dudasdavid/co2-monitor-gen2/documents/spi/ESP32S3-128SPIx系列开发板开发参考  V1.0.pdf

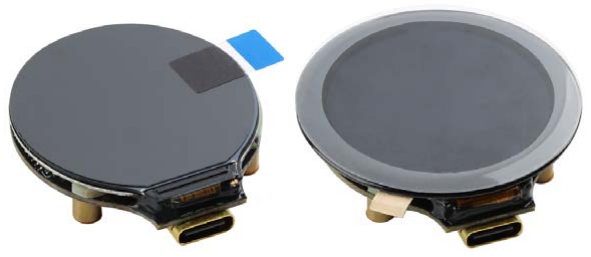
[picture p34: figure]

1 / 24

## 1.28 寸 ESP32S3 圆形 TFT-SPI 屏幕开发板

开发参考文档

时间 2025/04/19

版本 V1.0

2 / 24

修订历史

日期 | 版本 | 发布说明
2025-04-19 | V1.0 | ● 首次发布

3 / 24

一、 文档说明

开发板主体以 ESP32-S3 为核心，并搭配丰富的外设以及供电等电

路设计，开发板通过长按中间按键 3S 实现开关机，本文档展开对开

发板各个板块的功能进行分析以便用户进行开发。

文档按照下面几大方面对开发板进行拆解分析，注意代码部分需

要配合资料工程 FullFunctionTest 阅读，共同学习进步。

ESP32-S3 核心参数

UPS 供电切换稳压 & 开关机

锂电池充电 & 电量检测

屏幕参数显示 & 电容触摸

物理按键

QMI8658 陀螺仪

PCF85063 RTC 时钟

TF 卡

IIS 音频输出 & MIC

WS2812 & 扩展 IO

二、 ESP32-S3 核心参数

ESP32-S3 核心部分有 ESP32-S3 芯片，外挂的 FLASH & PSRAM,以

及下载模式控制按键与天线几大部分组成。

ESP32-S3 芯片运行频率及基本功能等参数不再赘述，可参考官方

芯片手册。

本次开发板，外挂有 16MB 的 FLASH,采用四线 SPI 进行连接。

4 / 24

PSRAM 部分为 ESP32-S3 芯片内置，出货有 8MB 和 16MB 两种版本

供用户选择，PSRAM 内部为 OPI 连接方式，使用时务必选择 OPI PSRAM，

否则将会无法识别。

开发板仅有的 USB 口连接至芯片的 IO19 D- 和 IO20 D+ 两个引

脚用于下载调试，因此在下载时请选择 USB 下载，而非 UART 下载，

而对于想要使用 USB 口进行串口打印的用户，打开 USB CDC On Boot

的功能可以使用 Serial.print 等语法打印调试信息。

对于部分用户会出现烧录时代码选项设置为关闭 USB，这在下载

之后将无法再找到 USB 口，电脑也无法再识别到 USB 口，以及关闭

USB 下载功能后识别到 USB 口但无法下载的情况，这种情况需要使用

板载的两颗微型物理按键进入下载模式，如下图

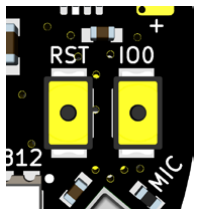
[picture p35: figure]

按住 IO0 按键不松，再次按下 RST 按键随后松开 RST 按键，再随后松

开 IO0 按键，ESP32-S3 将进入下载模式，值得注意的是此处的 IO0 按

键不建议作为常规物理按键去实现功能，因为 IO0 已经作为触摸复位

使用。

天线默认采用板载的天线，预留的 IPEX 需要更改电阻切换，外接

IPEX 天线需要将下方 0Ω电阻更换到另一侧的位置进行焊接。


5 / 24

→


三、 供电 & 开关机

供电部分提供了外部 VIN 输入焊盘，USB，以及 BAT 电池三种供电

方式。


其中 VIN 焊盘与 USB 的电源端直接连通，请注意使用，电压请勿

超过 5.5V，并且均可为电池进行充电。

USB 供电与电池供电使用两颗理想二极管实现 UPS 切换功能，电

流随后经过电源控制开关供电至 TPS63802 升降压芯片，稳压 3.3V 输

出给 ESP32-S3 以及其他板块使用。

电源控制开关由中间按键进行控制，长按 3 秒以上开机或关机，

因此平时可以作为普通按键进行使用。


关机后仅开关控制部分以及电池充电部分的电流消耗，实测关机后静

态电流约 7ua。

如果需要上电就开机而不是通过按键控制，那么可以短接下方图


6 / 24

示的两个焊点，短接后上电即开机。

四、 锂电池充电 & 电量检测

电池可以选择 3.7V 可充电锂电池，充电部分使用 BQ25170 芯片进

行充电。

BQ25170 支持以下电池

- 锂离子电池：4.05V、4.1V、4.2V、4.35V、4.4V
- 磷酸铁锂电池：3.5V、3.6V、3.7V

默认设置充电电压为 4.2V，适配标定 3.7V 的锂电池进行使用

依据芯片手册，通过修改下方位置电阻调节


对应关系如下

最大电流 800ma 可调节，电流默认设置为最大 600ma

7 / 24


对应关系如下 ICHG = KISET/RISET

其中 ICHG为需要设置的充电电流 KISET为增益因子，其值为 270-330 典

型值 300，由此可计算出对应充电电流需要使用的电阻 RISET，默认 499

Ω。

充电指示灯在无电池接入时，接入 USB 口或 VIN 供电指示灯会处

于闪烁的状态，接入电池后在充电状态下会常亮，充满后熄灭，充电

芯片并非低于 4.2V 就开始充电，而是有一个阈值，低于才开始充电，

属于正常现象，具体可参考资料中芯片手册。

值得注意的是 TPS63802 升降压芯片，可以在低至 2V 以下的电压

下工作，并且由于没有板载电池过放电路，因为电池选型是最好使用

带保护板型号的电池。

电量检测的方式以检测电池电压为主，电池电压通过两个 100K 电

阻分压后连接到 ESP32-S3 的 IO1 端口，参考下图即可


电池未接入时电压会处于浮动状态，上图为参考电路，不会增加开发

板静态功耗，静态功耗仍然会在 7ua 左右。

五、 屏幕 & 电容触摸

屏幕为圆形显示区域，1.28in 分辨率 240x240 的 IPS 彩色显示

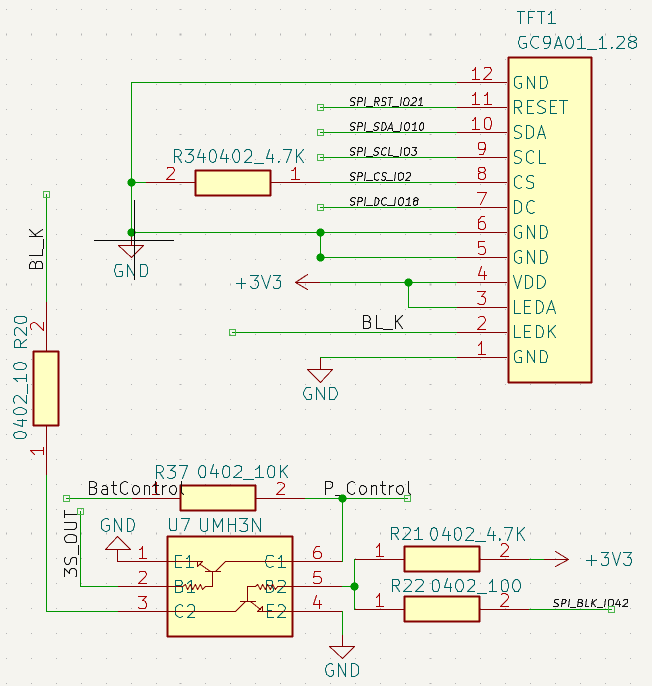
[picture p36: figure]

8 / 24

屏，其驱动为 GC9A01,硬件驱动接口为 SPI 接口，部分文档叫串行接

口，和 ESP32-S3 的连接可参照下图部分

SDA | 数据引脚 | IO10
RST | 复位引脚 | IO21
SCL | 时钟引脚 | IO3
DC | 数据/命令 | IO18
CS | 片选 | IO2
BLK | 背光控制 | IO42

提供的测试代码使用 Arduino_GFX_Library (https://github.com/moononournation/Arduino_GFX) 的库进行驱动，由于

该库存在多个版本，并且不完全兼容，建议使用资料中已经打包好的

1.4.7 版本库，解压后添加到 Arduino IDE 存放库的路径下即可，不

做过多赘述

示例代码中

1 | #include <Arduino_GFX_Library.h> //添加库文件引用

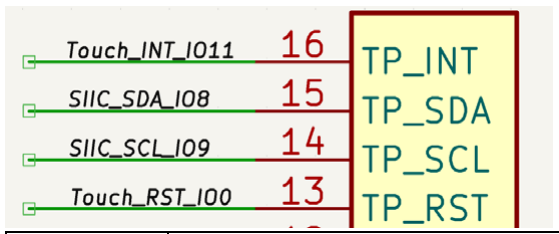
[picture p37: figure]

9 / 24

通过下方代码进行初始化

1

2

3

4

5

#define GFX_BL 42

#define BL_Freq 5000

unsigned int BL_Brightness = 255;

Arduino_DataBus *bus = new Arduino_ESP32SPI(18 /* DC */, 2 /* CS */, 3 /* SCK */, 10 /* MOSI */, -1 /* MISO */, HSPI /* spi_num */);

Arduino_GFX *gfx = new Arduino_GC9A01(bus, 21 /* RST */, 0 /* rotation */, true /* IPS */);

1

2

gfx ->begin(); //Initialize LCD

gfx->fillScreen(BLACK); //Background color Black
随后即可调用 ARDUINO GFX 库中所提供的函数进行显示驱动

可参照 gfx->fillScreen(BLACK); 设置背景色为黑色等功能，具体可查看库作者的

github：https://github.com/moononournation/Arduino_GFX

电容触摸使用 CST816 触摸专用芯片(仅触摸版本查看),采用 IIC

驱动，带复位及中断引脚，IIC 器件地址 0x15，与 ESP32-S3 的硬件

连接如下图所示

SDA | 数据引脚 | IO8
SCL | 时钟引脚 | IO9
RST | 复位引脚,低电平有效 | IO0
INT | 中断引脚 | IO11

值得注意 RST 与 INT 引脚，RST 引脚使用 IO0，因此前文 IO0 按键在

触摸版本中无法当普通按键使用，否则会影响到触摸功能。

示例代码中下方位置定义了 IIC 使用的引脚

10 / 24

1 | //IIC
2 | #define SCL 9
3 | #define SDA 8
以下代码定义了复位引脚，IIC 器件地址 0x15 以及 ID 寄存器地址与

寄存器中值的含义

01 | //CST816
02 | #define TouchRST 0
03 | #define TouchInt 11
04 | #define TouchI2CAddr 0x15

05

06 | #define ChipIdRegister 0xA7
07 | #define CST716ChipId 0X20
08 | #define CST816SChipId 0XB4
09 | #define CST816TChipId 0XB5
10 | #define CST816DChipId 0XB6
11 | #define CST826ChipId 0X11
12 | #define CST830ChipId 0X12

#define CST836UChipId 0X13

以下代码复位触摸芯片并检测芯片 ID 判断触摸芯片具体型号
01 | pinMode(TouchRST, OUTPUT);
02 | pinMode(TouchInt,INPUT_PULLUP);
03 | attachInterrupt(digitalPinToInterrupt(TouchInt), TouchHandleInterrupt, FALLING);
04 | digitalWrite(TouchRST, LOW); delay(10);
05 | digitalWrite(TouchRST, HIGH); delay(50);

06

07 | Wire.beginTransmission(TouchI2CAddr);
08 | Wire.write(ChipIdRegister);
09 | Wire.endTransmission(false);
10 | Wire.requestFrom(TouchI2CAddr, 1 ,true);
11 | ChipID = Wire.read();
1 | Serial.printf("\r\nTouchChipID: 0x%02X",ChipID);
2 | if(ChipID == CST716ChipId) Serial.println(",Touch chip model :CST716");
3 | else if(ChipID == CST816SChipId) Serial.println(",Touch chip model :CST816S");
4 | else if(ChipID == CST816TChipId) Serial.println(",Touch chip model :CST816T");
5 | else if(ChipID == CST816DChipId) Serial.println(",Touch chip model :CST816D");
6 | else if(ChipID == CST826ChipId) Serial.println(",Touch chip model :CST826");
7 | else if(ChipID == CST830ChipId) Serial.println(",Touch chip model :CST830");
8 | else if(ChipID == CST836UChipId) Serial.println(",Touch chip model :CST836U");
9 | else Serial.println(",error!");

11 / 24

坐标检测函数

01 | void my_touch_read(lv_indev_drv_t * indev_drv, lv_indev_data_t * data){
02 | //Store the pressed coordinates and status
03 | lv_coord_t last_x = 0;
04 | lv_coord_t last_y = 0;
05 | unsigned int X_H4 = 0;
06 | unsigned int X_L8 = 0;
07 | unsigned int Y_H4 = 0;
08 | unsigned int Y_L8 = 0;
09 | //True if there is touch, false otherwise
10 | if(TouchEventFlag) {
11 | Wire.beginTransmission(TouchI2CAddr);
12 | Wire.write(0x03);
13 | Wire.endTransmission(false);
14 | //Wire.beginTransmission(TouchI2CAddr);
15 | Wire.requestFrom(TouchI2CAddr, 1 ,true);
16 | X_H4 = Wire.read();

17

18 | Wire.beginTransmission(TouchI2CAddr);
19 | Wire.write(0x04);
20 | Wire.endTransmission(false);
21 | //Wire.beginTransmission(TouchI2CAddr);
22 | Wire.requestFrom(TouchI2CAddr, 1 ,true);
23 | X_L8 = Wire.read();

24

25 | Wire.beginTransmission(TouchI2CAddr);
26 | Wire.write(0x05);
27 | Wire.endTransmission(false);
28 | //Wire.beginTransmission(TouchI2CAddr);
29 | Wire.requestFrom(TouchI2CAddr, 1 ,true);
30 | Y_H4 = Wire.read();

31

32 | Wire.beginTransmission(TouchI2CAddr);
33 | Wire.write(0x06);
34 | Wire.endTransmission(false);
35 | //Wire.beginTransmission(TouchI2CAddr);
36 | Wire.requestFrom(TouchI2CAddr, 1 ,true);
37 | Y_L8 = Wire.read();

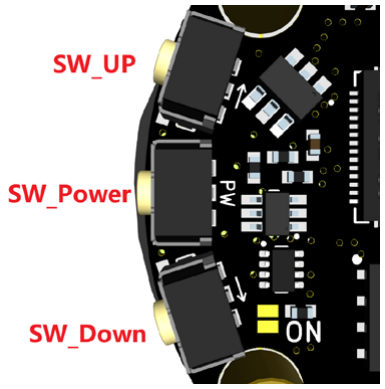
[picture p38: figure]

12 / 24

01 | last_x = 0xFF - (X_H4 << 8 | X_L8)&0X0FFF;
02 | last_y = (Y_H4 << 8 | Y_L8)&0X0FFF;
03 | data->point.x = last_x;
04 | data->point.y = last_y;

05

06 | TouchEventFlag = false;
07 | //Serial.printf("Touch Point:%02X , %02X \r\n",last_x,last_y);
08 | data->state = LV_INDEV_STATE_PR;
09 | }
10 | else {
11 | data->state = LV_INDEV_STATE_REL;
12 | }
13 | }
注意以上代码需要搭配完整代码使用，并非直接复制使用的，仅作

为代码分析学习共同进步的作用

六、 物理按键

开发板板载有 5 个物理按键，其中两个模式控制及复位不作为普

通按键使用，三个侧面按键连接至 TCA6408 的 P3 P4 P5,按键连

接参考与位置如图所示

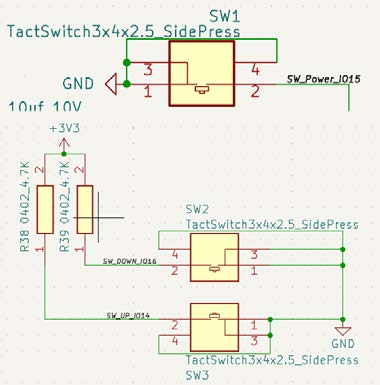
[picture p39: figure]

值得一说的是中间的按键不仅作为普通按键使用还承担了电源开

关的功能，长按 3 秒将会让开发板开机或关机，当然，再次说明可

以短接下方 ON 位置焊盘来取消开关机的功能。

七、 QMI8658 陀螺仪(未焊接)

13 / 24

QMI8658 是一颗六轴惯性测量单元芯片，具有三轴陀螺仪、三轴加

速度计，足够进行姿态以及运动状态检测，通过 IIC 与 ESP32-S3 进

行通信，带两个中断引脚，分别对应陀螺仪的中断与加速度计的中断

供用户使用。

其 IIC 器件地址为 0x6B，开发板上连接可参照下图或表

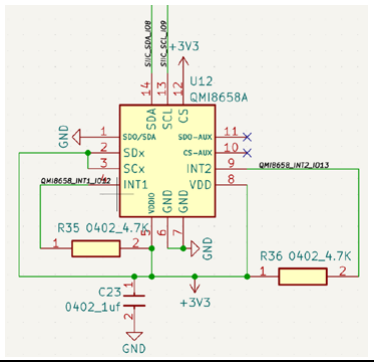
[picture p40: figure]

SCL | 时钟引脚 | IO9
SDA | 数据引脚 | IO8
IMU_INT1 | 中断引脚 1 | IO12
IMU_INT2 | 中断引脚 2 | IO13

驱动代码可参考资料工程 FullFunctionTest 以及芯片手册进行

阅读，足够了解该类型芯片的用户可以自行编码驱动，或者选型移

植示例中的代码，本代码中 IMU 部分同样移植自微雪的示例，节省

大量时间，感谢微雪电子，同时也建议移植已验证代码去使用。

八、 PCF85063 RTC 时钟(未焊接)

PCF85063 这颗 RTC 时钟芯片同样采用 IIC 进行通信，得益于 IIC

总线的特性，他与开发板上其他 IIC 器件一样均共用一组 IIC 引脚，

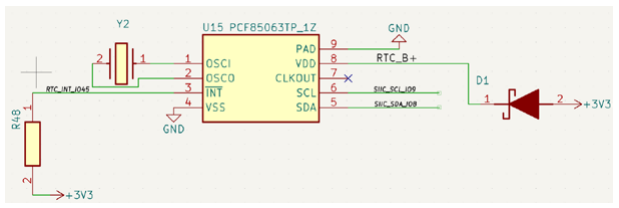
[picture p41: figure]

14 / 24

用于设置或读取时间等参数。

除此之外这颗芯片拥有 INT 引脚，我们将他连接到了 TCA6408 扩

展芯片的 P7 引脚，INT 引脚设置半分钟或者一分钟中断，可以在

ESP32-S3 进入低功耗的状态下通过这个中断的状态进行唤醒，当然

也可以用于其他的有趣的方案。

芯片于开发板其他部件的连接可以参考下图或表

SCL | 时钟引脚 | IO9
SDA | 数据引脚 | IO8
INT | RTC 中断引脚 | IO45

对于电源部分，RTC 的电源显然是非常重要的，板载有 RTC 电池

的连接端口，推荐使用 3V 电压的可充电电池，在 RTC 电池未接入时

芯片通过板载的 3.3V 稳压获取电源，RTC 电池接入后 3.3V 将会给

RTC 电池进行充电，在开发板关机时芯片将由 RTC 电池进行续电工作，

静态电流可以参考芯片手册。

PCF85063 拥有 11 个寄存器，每个寄存器有 8 个位，可以分为两

类，一类为配置参数，另一类为时间参数。

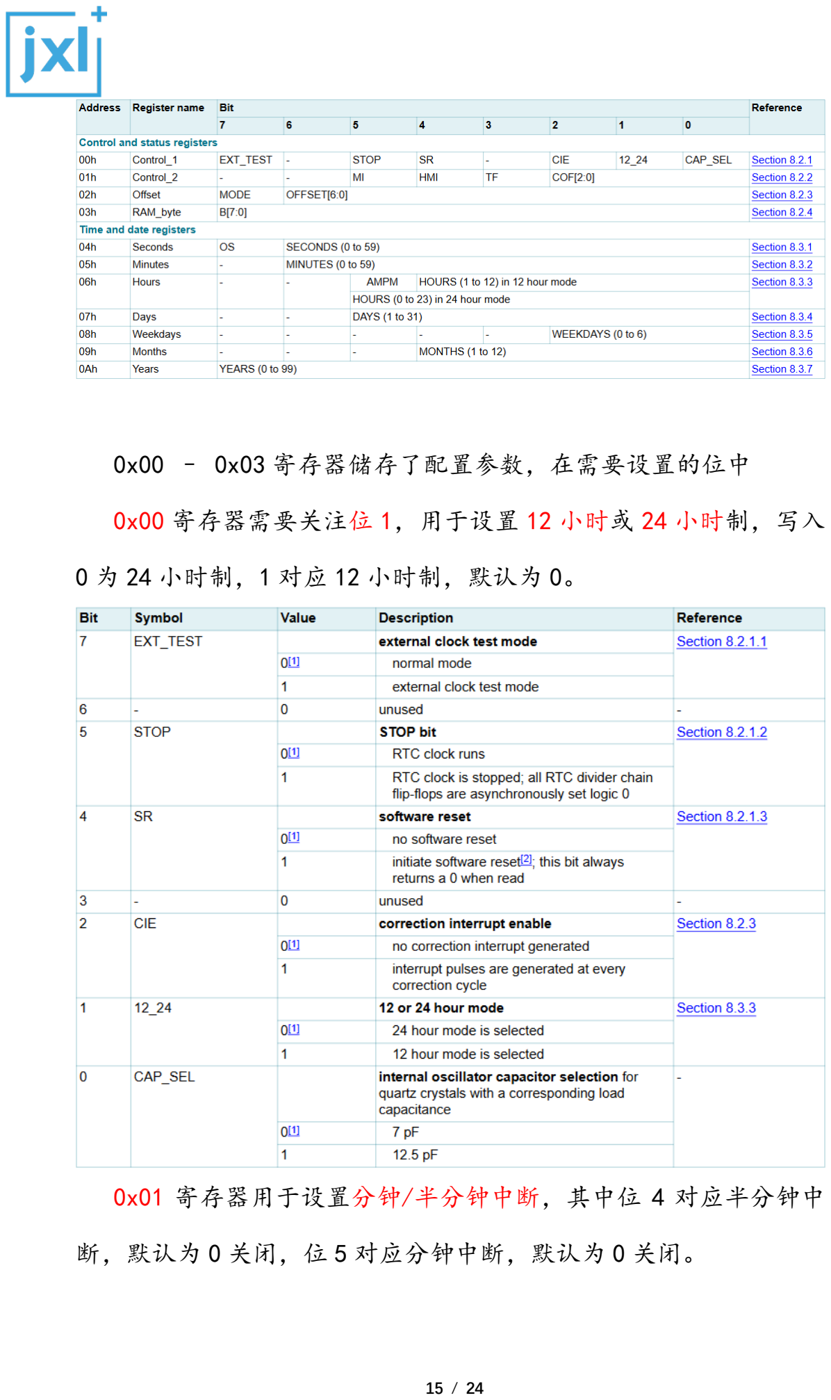
[picture p42: page 15]

15 / 24

0x00 – 0x03 寄存器储存了配置参数，在需要设置的位中

0x00 寄存器需要关注位 1，用于设置 12 小时或 24 小时制，写入

0 为 24 小时制，1 对应 12 小时制，默认为 0。

0x01 寄存器用于设置分钟/半分钟中断，其中位 4 对应半分钟中

断，默认为 0 关闭，位 5 对应分钟中断，默认为 0 关闭。

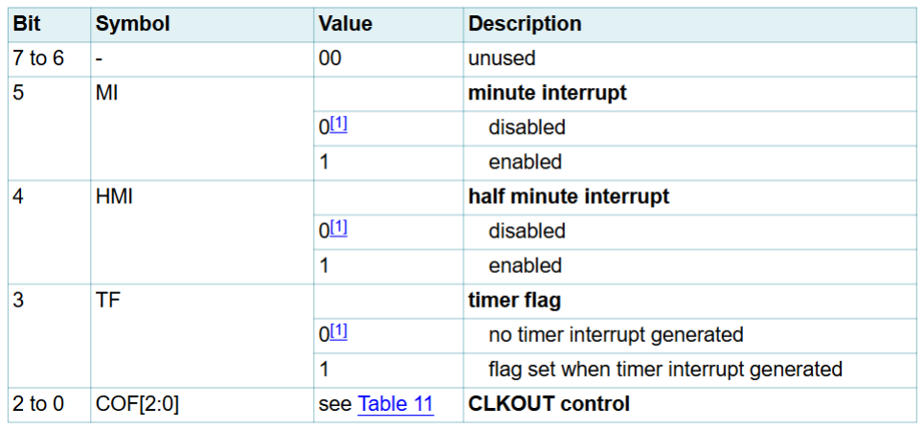
[picture p43: figure]

16 / 24

0X02 寄存器用于设置偏移量，在运行中芯片会由于晶振精度，负

载电容精度，老化以及温漂等因素难以做到 0 偏差，此寄存器用于纠

正此偏差以达到更精准的计时。

寄存器位 0 到位 6 存储偏移的值，位 7 - MODE 为偏移模式设置，

当 MODE 设置为 0 时为正常模式，每两小时调整一次偏移量，此时

存储的偏移量为 1 个单位 4.34ppm，也就是说具体的偏移量需要将位

0-6 里面存储的值*4.34，单位 ppm。

如果 MODE 设置为了 1，那么芯片将会每 4 分钟调整一次偏移，此

时的偏移量为 1 个单位 4.069ppm。

位 1 到 6 中存储的值为补码值，需要进行换算，可以以参照下表

或芯片手册查看更详细信息。

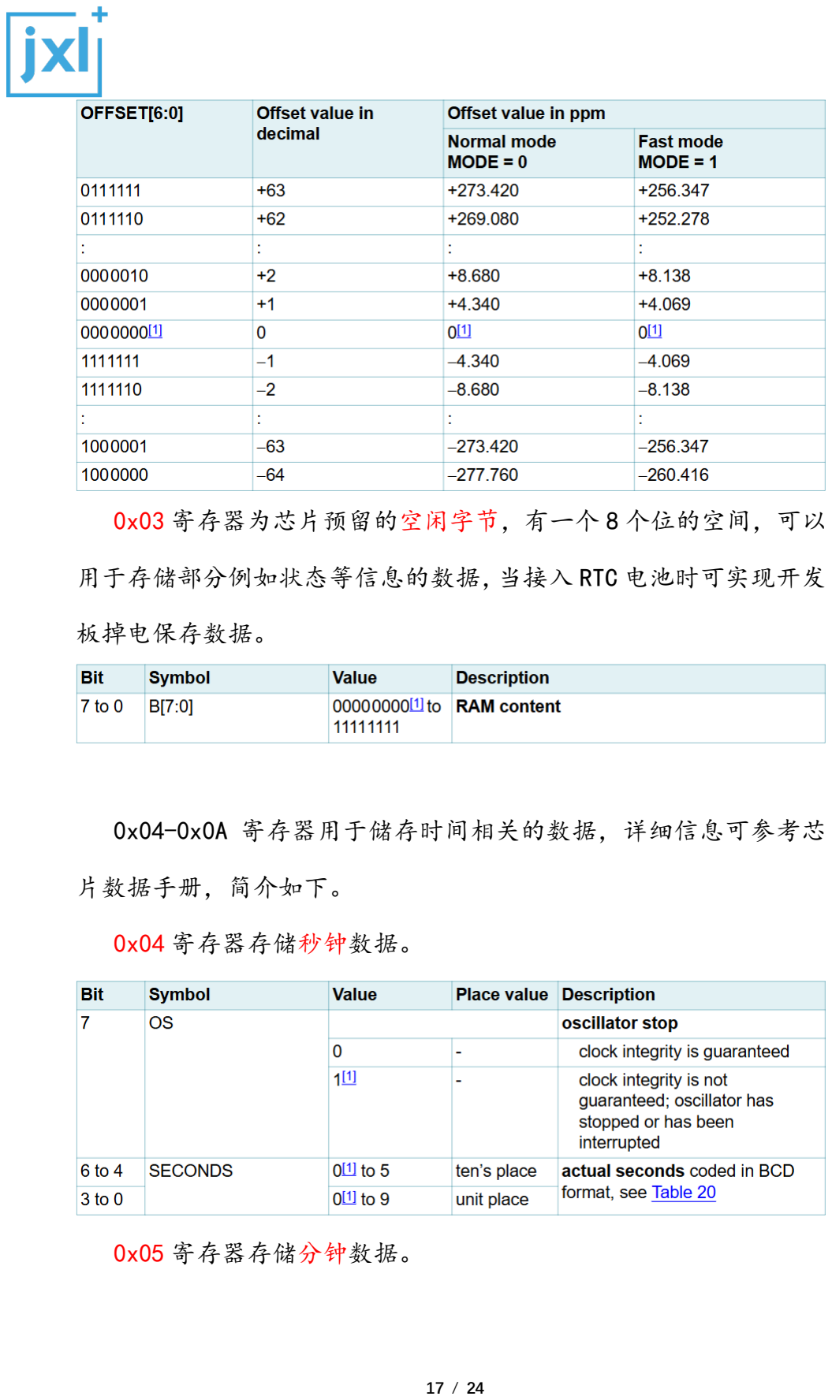
[picture p44: page 17]

17 / 24

0x03 寄存器为芯片预留的空闲字节，有一个 8 个位的空间，可以

用于存储部分例如状态等信息的数据，当接入 RTC 电池时可实现开发

板掉电保存数据。

0x04-0x0A 寄存器用于储存时间相关的数据，详细信息可参考芯

片数据手册，简介如下。

0x04 寄存器存储秒钟数据。

0x05 寄存器存储分钟数据。


18 / 24

0x06 寄存器存储小时数据，分为 12 小时制和 24 小时制，存在两

种数据获取方法，在 0x00 寄存器中设置小时制。

0x07 寄存器存储日期/天数据，注意设置月和年，此处并非按照一

月 30 天计算，而是区分了 30/31 天的大小月，并且包括对闰年自动

计算 2 月的天数。

0x08 寄存器存储周/星期数据，注意数据 0 为周日/天，星期七并

非对应数据 7

0x09 寄存器存储月数据

19 / 24

0x0A 寄存器存储年数据

对于 RTC 的使用，注意设置年月信息，即使用不上，对于偏移量

的设置，需要运行固定时间时候对比标准时间的偏差才能计算出需要

设置的偏移量，并不能在未测试的情况下直接设置，具体可参考芯片

手册更加详细说明。

九、 TF 卡

TF 卡座采用 SPI 的连接方式和 ESP32-S3 进行连接，因此需要使

用支持 SPI 协议的 TF 卡，市面上绝大部分卡都支持，但也买到过部

分低价不支持的 SPI 协议的 TF 卡，IO 连接可参考下图或表

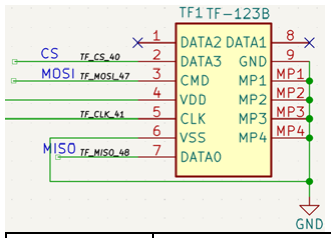
[picture p45: figure]

CS | SPI 片选引脚 | IO40
CLK | SPI 数据引脚 | IO41
MOSI | SPI 数据引脚 | IO47
MISO | SPI 数据引脚 | IO48

TF 卡可以借助 #include <SD.h> 的库文件 以及 File vFile;

20 / 24

文件系统进行操作，可以参考示例代码中播放 TF 卡视频的部分。

初始化并判断 TF 卡是否存在

1 | pinMode(SD_CS,INPUT_PULLUP);
2 | delay(10);
3 | SPI.begin(SCK, MISO, MOSI, SD_CS);
4 | delay(10);
5 | if (!SD.begin(SD_CS, SPI, 80000000)) //1-bit SD bus mode
播放视频
01 | {
02 | uint8_t *mjpeg_buf = (uint8_t *)ps_malloc(MJPEG_BUFFER_SIZE);
03 | Start:
04 | vFile = SD.open(MJPEG_FILENAME);
05 | if (!vFile || vFile.isDirectory())
06 | {
07 | Serial.println(F("ERROR: Failed to open " MJPEG_FILENAME " file for reading"));
08 | vTaskDelayUntil(&lastWakeTime, pdMS_TO_TICKS(1000));
09 | esp_restart();
10 | }
11 | else
12 | {
13 | mjpeg.setup(&vFile, mjpeg_buf, displayBack , true , 0 , 0 , gfx->width() /* widthLimit */, gfx->height());
14 | Serial.println(F("MJPEG video start"));
15 | while (vFile.available() && mjpeg.readMjpegBuf())
16 | {
17 | // Play video
18 | mjpeg.drawJpg();
19 | //Serial.printf("\r\nmainTask: %d", uxTaskGetStackHighWaterMark(NULL));
20 | vTaskDelayUntil(&lastWakeTime, pdMS_TO_TICKS(33));
21 | }
22 | vTaskDelayUntil(&lastWakeTime, pdMS_TO_TICKS(10));
23 | Serial.println(F("MJPEG video end"));
24 | vFile.close();
25 | goto Start;
26 | }
27 | }
TF 卡位置处于 PCB 板与屏幕之间，设计外壳需要注意开孔，因为

不在 PCB 正面容易观察到，设计时容易将其遗漏。


21 / 24


TF 卡安装时有金属触点一点朝向底部(屏幕显示的相反面)。

十、 IIS 音频输出 & MIC(未焊接)

音频输出与 MIC 的音频采集，均采用 IIS 进行驱动连接，采用

Duplex I2S 模式与 ESP32 进行连接，即共用 IIS 的时钟和左右声道

引脚。

IIS 音频输出采用 MAX98357 芯片，最大输出功率 3W，按实际使用

的效果来看，建议使用 8Ω的喇叭。

与 ESP32-S3 连接可参考下图或表

WS | 左右声道 | IO4
BCLK | 时钟引脚 | IO5
DIN | 数据引脚 | IO7


22 / 24

喇叭连接位置如下图所示，需要将喇叭线焊接至对应焊盘。


如果需要保持小体积，建议使用手机以及手表上使用的喇叭型号，

配合外壳做成腔体的情况下可以实现较大音量的输出，需要注意做成

腔体很重要，将会在很大程度上影响输出声音的大小。

音频采集使用的 ICS43434，一颗常用的 IIS 麦克风，与 ESP32-

S3 连接可参考下图或表

WS | 左右声道 | IO4
BCLK | 时钟引脚 | IO5
DOUT | 数据引脚 | IO6

在开发板侧面有一个缺口用于采集声音，请勿将这个缺口堵塞，

即使制作外壳也需要对这个位置开孔。


23 / 24

对于 IIS 音频的采集与输出，示例代码以播放 MJPEG 文件为主，

没有音频信号，目前测试使用 github 上开源小智 AI 代码移植后进行

测试，感谢小智 AI 作者开源如此优质的项目，开源地址如下

https://github.com/78/xiaozhi-esp32
十一、 WS2812(未焊接) & 扩展 IO

开发板板载有两颗 WS2812-RGB 灯，通过单总线连接，通过 ESP32-

S3 的 46 号引脚进行驱动，其中第一颗在麦克风边上，位置如下

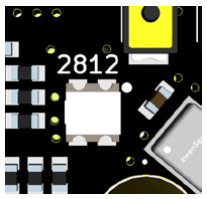
[picture p46: figure]

第二颗与第一颗串联连接，位置在 PCB 板与屏幕之间(PCB 板的反

面)，如下图所示

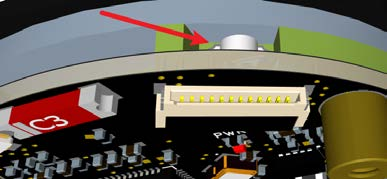
[picture p47: figure]

示例代码中使用 #include <Adafruit_NeoPixel.h> 库进行驱动，

下面代码添加头文件并设置 WS2812 使用引脚以及数量

1

2

3 | #define WS2812Pin 46
4 | #define WS2812_Count 2
5 | Adafruit_NeoPixel strip(WS2812_Count, WS2812Pin, NEO_GRB + NEO_KHZ800);

#include <Adafruit_NeoPixel.h>

初始化并设置初始颜色


24 / 24

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
void WS2812Init(){

strip.begin(); //Initializing the WS2812

strip.clear(); //Clear All LEDs

strip.show(); //Turn off all lights

//Set the first light to red (R, G, B)

strip.setPixelColor(0, strip.Color(20, 0, 0));

//Set the second light to green

strip.setPixelColor(1, strip.Color(0, 20, 0));

strip.show(); //Send data to update the lamp beads

}

开发板板载有扩展接口，引脚顺序如下所示

参考规划中如下

IO7/6/5/4 | IIS 使用 | 不可用或无需音频功能可当 IO 口使用
IO44/43 | UART0 | 44–RXD 43-TXD 外接 GPS/4G 等
IO39/38 | IIC2/IO*2 | 普通 IO 或第二组 IIC 功能的启用
IO8/9 | IIC1 | 8–SDA 9-SCL 与开发板传感器共同 注意地址冲突

至此，开发板基本功能简介均在以上文档中，欢迎向我们提交 BUG

以便我们修复或将产品做到更好。
