dudasdavid/co2-monitor-gen2/firmware/images/welcome.png

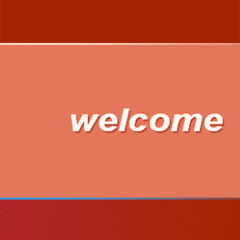
firmware/images/welcome.png
