dudasdavid/co2-monitor-gen2/mechanical/_round_esp32v2_spi.SLDASM

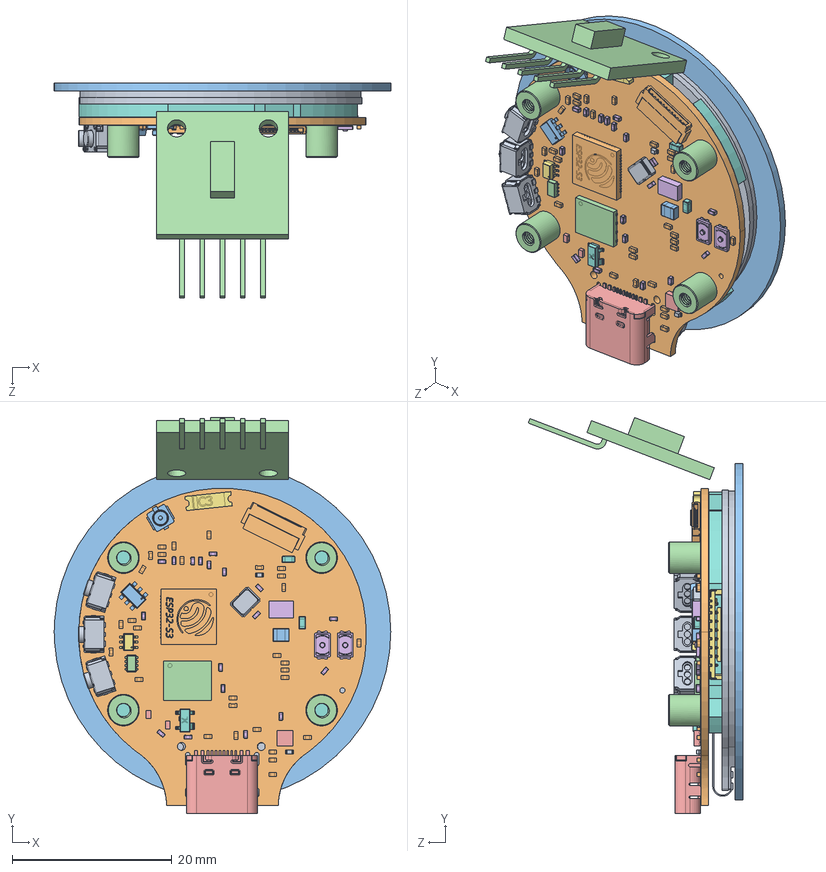
[picture p49: CAD file, 2026-09-22]
mechanical/_round_esp32v2_spi.SLDASM
42.2 x 49.6 x 26.9 mm
COMPOUND_20_GC9A01
ESP32S3_SPI_GC9A01 PCB
Outside glass^ESP32S3_SPI_GC9A01
veml7700
