dudasdavid/co2-monitor-gen2/mechanical/ESP32S3_SPI_GC9A01/GC9A01_1.28.SLDASM

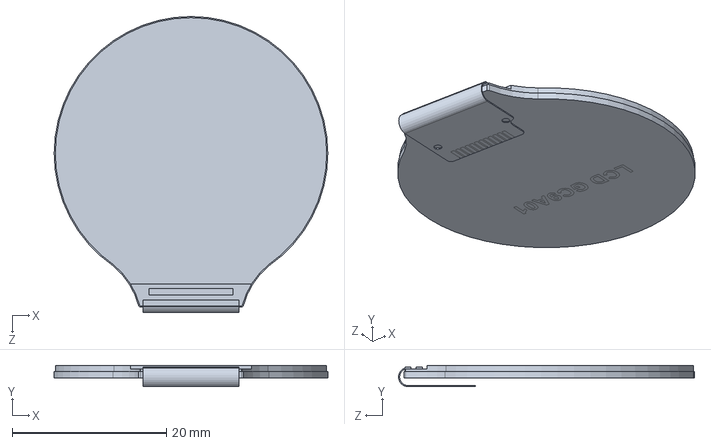
[picture p50: CAD file, 2026-03-19]
mechanical/ESP32S3_SPI_GC9A01/GC9A01_1.28.SLDASM
35.5 x 2.77 x 38.4 mm
