dudasdavid/co2-monitor-gen2/mechanical/ESP32S3_SPI_GC9A01/ESP32S3_SPI_GC9A01.SLDASM

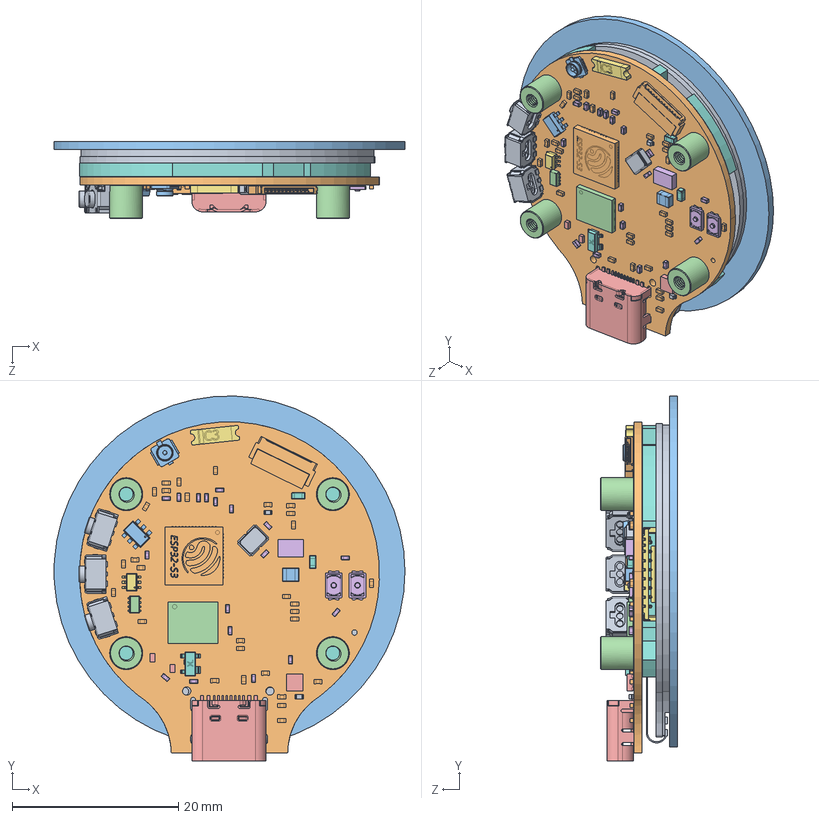
[picture p51: CAD file, 2026-03-19]
mechanical/ESP32S3_SPI_GC9A01/ESP32S3_SPI_GC9A01.SLDASM
42.2 x 43.9 x 9.29 mm
COMPOUND_20_GC9A01
ESP32S3_SPI_GC9A01 PCB
Outside glass^ESP32S3_SPI_GC9A01
