dudasdavid/co2-monitor-gen2/mechanical/ESP32S3_I80_GC9A01/ESP32S3_I80_GC9A01_Touch.SLDASM

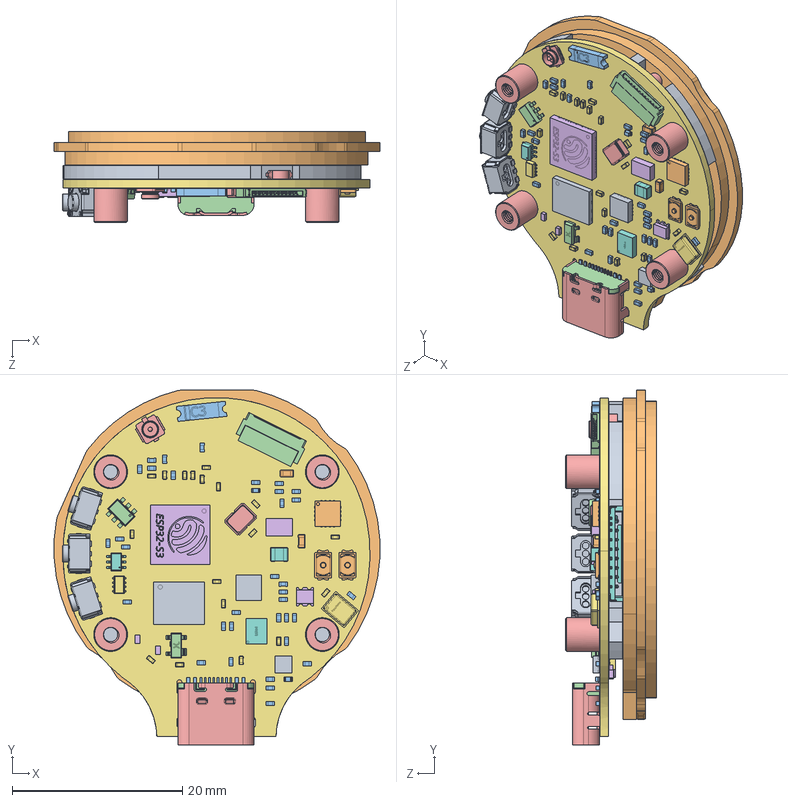
[picture p52: CAD file, 2026-03-19]
mechanical/ESP32S3_I80_GC9A01/ESP32S3_I80_GC9A01_Touch.SLDASM
38.2 x 41.7 x 10.6 mm
ESP32S3_I80_GC9A01_Touch PCB
