dudasdavid/co2-monitor-gen2/mechanical/round_case_v2.SLDPRT

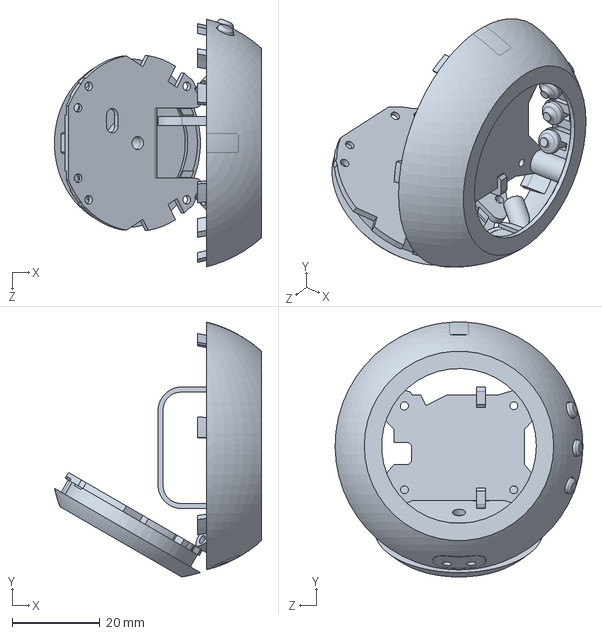
[picture p53: CAD file, 2026-11-09]
mechanical/round_case_v2.SLDPRT
47.1 x 58.0 x 56.4 mm
