dudasdavid/co2-monitor-gen2/mechanical/m3nut.SLDPRT

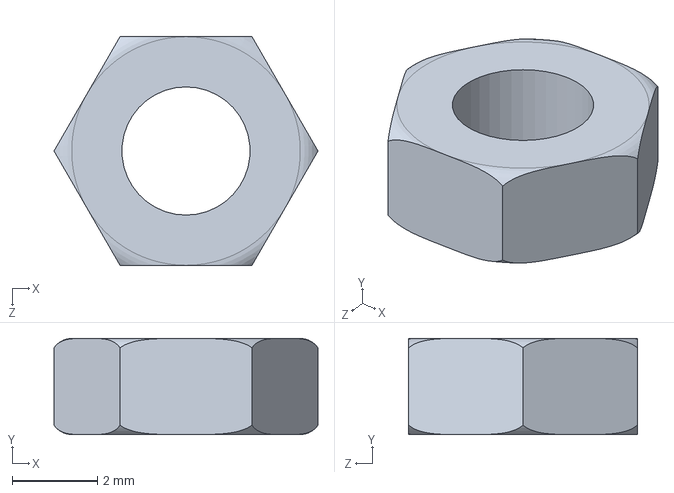
[picture p54: CAD file, 2026-11-09]
mechanical/m3nut.SLDPRT
6.18 x 2.25 x 5.35 mm
