dudasdavid/co2-monitor-gen2/mechanical/type_c_board.SLDPRT

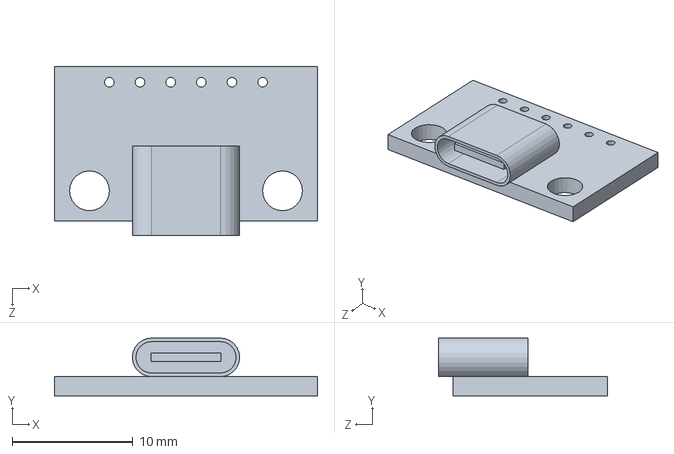
[picture p55: CAD file, 2026-09-22]
mechanical/type_c_board.SLDPRT
21.8 x 4.80 x 14.0 mm
