dudasdavid/co2-monitor-gen2/mechanical/veml7700.SLDPRT

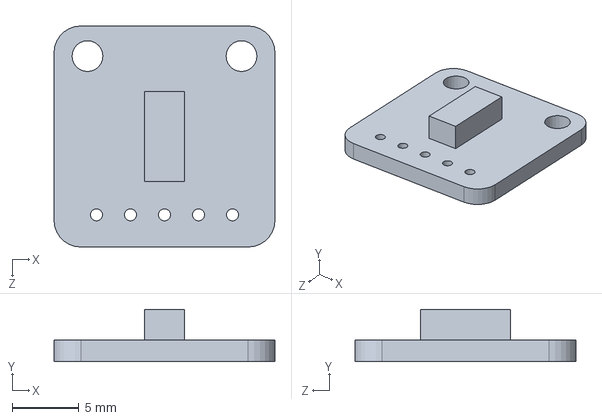
[picture p56: CAD file, 2026-09-22]
mechanical/veml7700.SLDPRT
16.5 x 3.90 x 16.5 mm
