dudasdavid/co2-monitor-gen2/mechanical/ds3231_step_import.SLDPRT

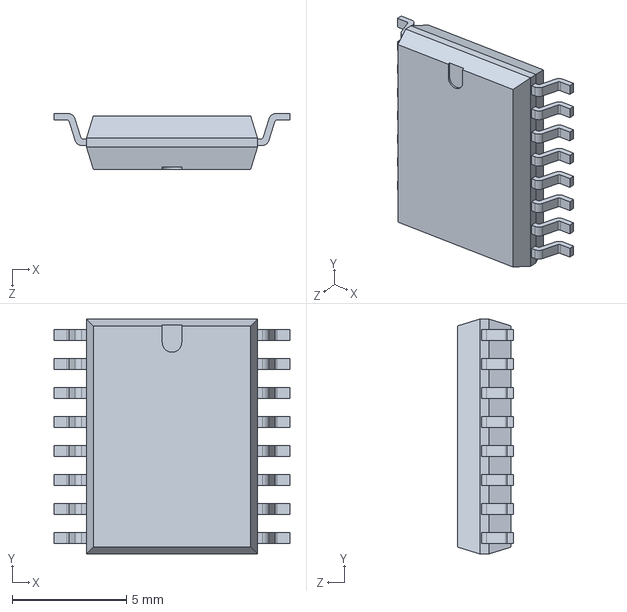
[picture p57: CAD file, 2026-09-22]
mechanical/ds3231_step_import.SLDPRT
10.4 x 10.3 x 2.45 mm
