dudasdavid/co2-monitor-gen2/mechanical/custom_pcb.SLDPRT

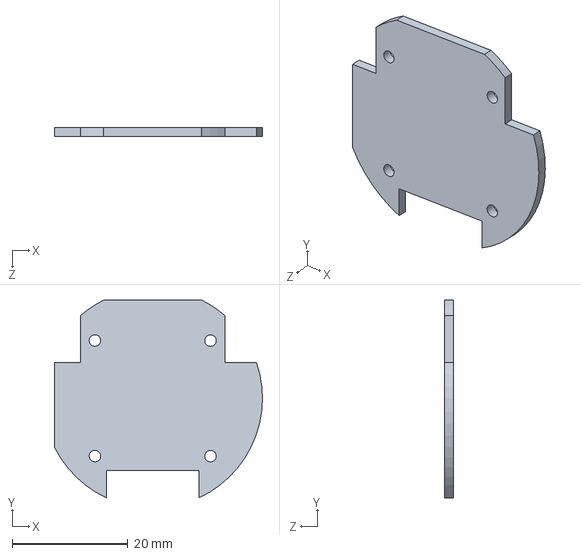
[picture p58: CAD file, 2026-09-22]
mechanical/custom_pcb.SLDPRT
36.0 x 34.2 x 1.60 mm
