dudasdavid/co2-monitor-gen2/mechanical/SCD4x_step_import.SLDPRT

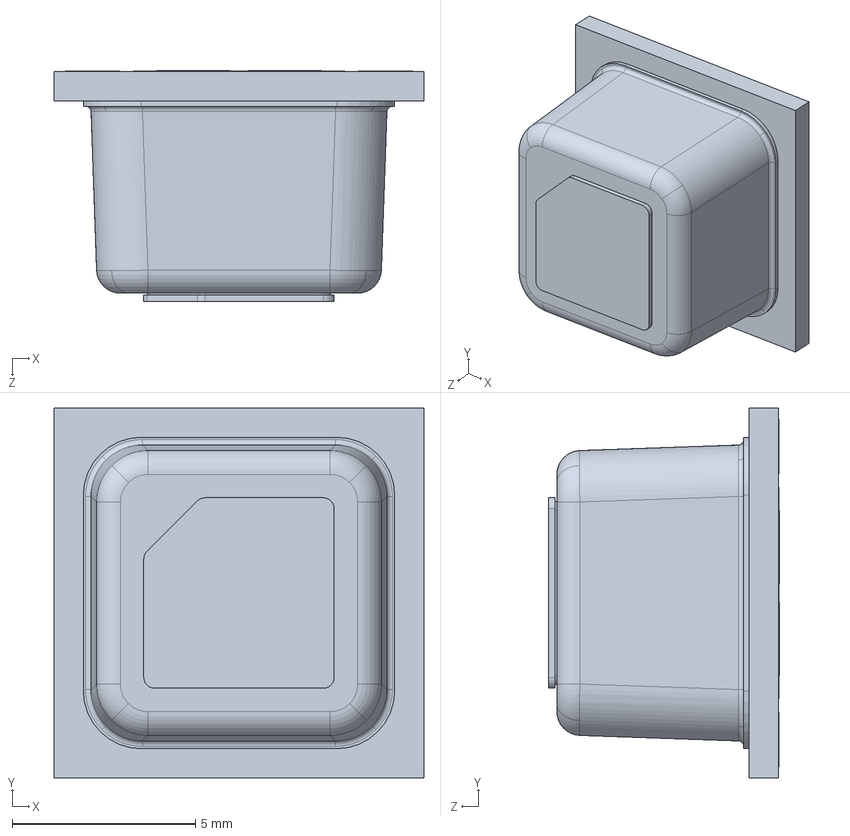
[picture p59: CAD file, 2026-09-22]
mechanical/SCD4x_step_import.SLDPRT
10.1 x 10.1 x 6.31 mm
