dudasdavid/co2-monitor-gen2/mechanical/type_c_connector.SLDPRT

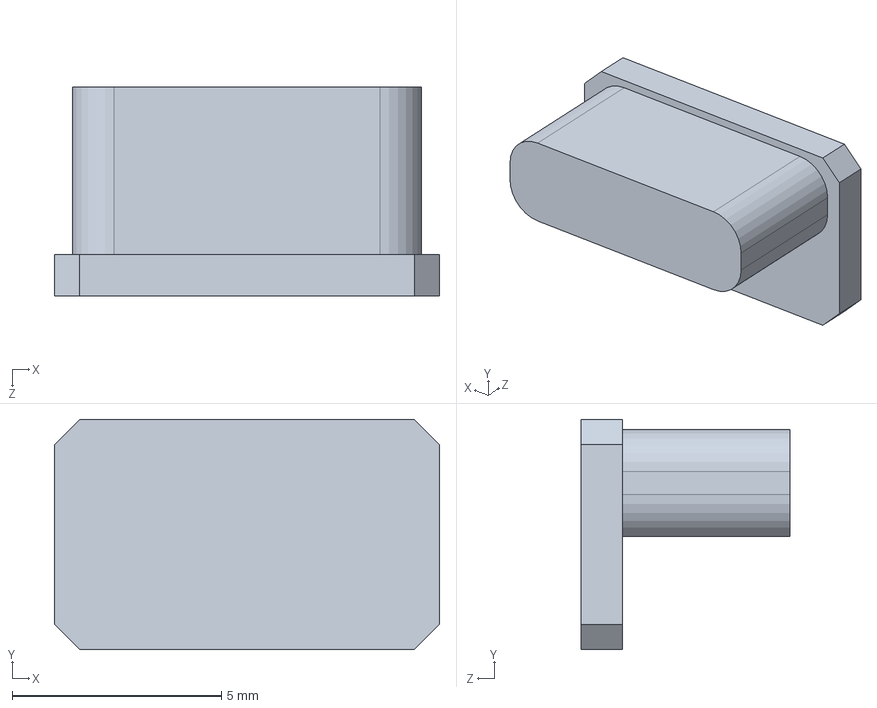
[picture p60: CAD file, 2026-03-19]
mechanical/type_c_connector.SLDPRT
9.20 x 5.50 x 5.00 mm
