dudasdavid/co2-monitor-gen2/mechanical/sd_card_adapter.SLDPRT

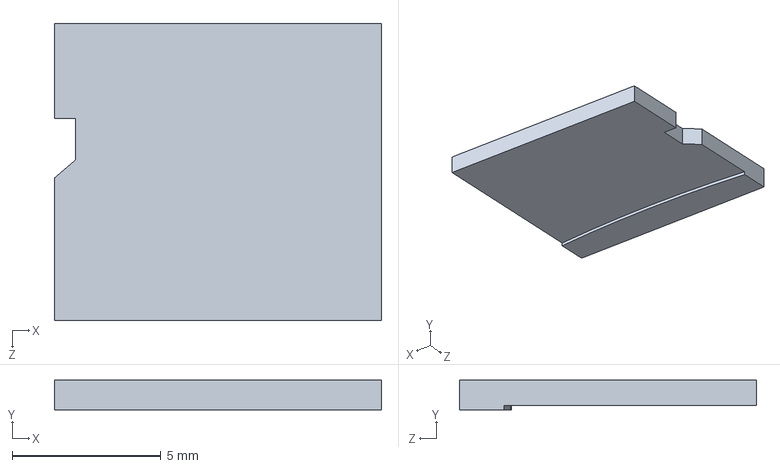
[picture p61: CAD file, 2026-03-19]
mechanical/sd_card_adapter.SLDPRT
11.0 x 1 x 10.0 mm
