dudasdavid/co2-monitor-gen2/mechanical/round_case_v2_spi.SLDPRT

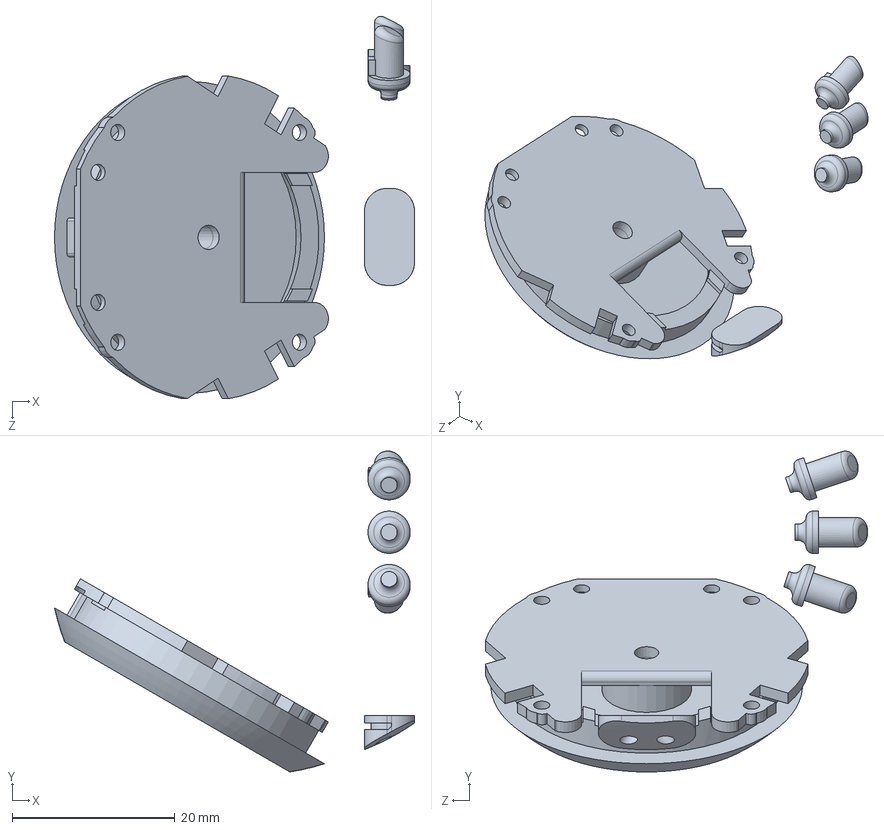
[picture p62: CAD file, 2026-03-19]
mechanical/round_case_v2_spi.SLDPRT
44.3 x 39.5 x 47.1 mm
