dudasdavid/co2-monitor-gen2/mechanical/scd41.SLDPRT

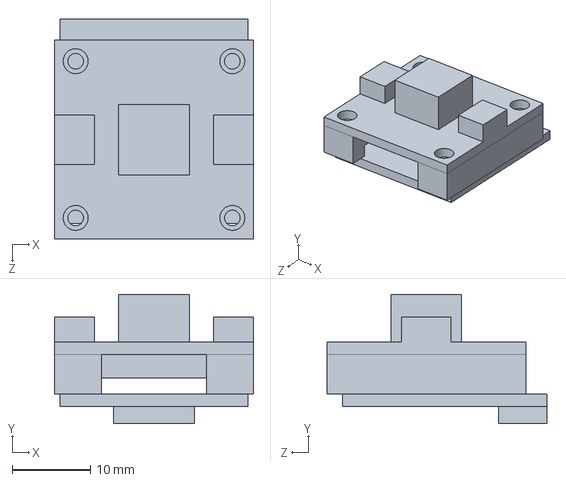
[picture p63: CAD file, 2026-03-19]
mechanical/scd41.SLDPRT
25.4 x 16.5 x 28.1 mm
