dudasdavid/co2-monitor-gen2/mechanical/Sensor PCBA/sensor_pcba.SLDASM

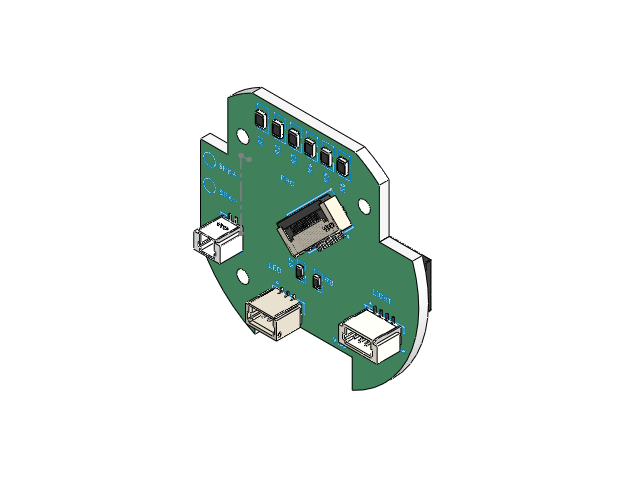
[picture p66: CAD file, 2026-09-22]
mechanical/Sensor PCBA/sensor_pcba.SLDASM
TopSilkscreen~trAu-0
TopSilkscreen~trAu-1
TopSilkscreen~trAu-2
TopSilkscreen~trAu-3
TopSilkscreen~trAu-4
TopSilkscreen~trAu-5
TopSilkscreen~trAu-6
TopSilkscreen~trAu-7
TopSilkscreen~trAu-8
TopSilkscreen~trAu-9
TopSilkscreen~trAu-10
TopSilkscreen~trAu-11
TopSilkscreen~trAu-12
TopSilkscreen~trAu-13
TopSilkscreen~trAu-14
TopSilkscreen~trAu-15
TopSilkscreen~trAu-16
TopSilkscreen~trAu-17
TopSilkscreen~trAu-18
TopSilkscreen~trAu-19
TopSilkscreen~trAu-20
TopSilkscreen~trAu-21
TopSilkscreen~trAu-22
TopSilkscreen~trAu-23
TopSilkscreen~trAu-24
TopSilkscreen~trAu-25
TopSilkscreen~trAu-26
TopSilkscreen~trAu-27
TopSilkscreen~trAu-28
TopSilkscreen~trAu-29
TopSilkscreen~trAu-30
TopSilkscreen~trAu-31
TopSilkscreen~trAu-32
TopSilkscreen~trAu-33
TopSilkscreen~trAu-34
TopSilkscreen~trAu-35
TopSilkscreen~trAu-36
TopSilkscreen~trAu-37
TopSilkscreen~trAu-38
TopSilkscreen~trAu-39
TopSilkscreen~trAu-40
TopSilkscreen~trAu-41
TopSilkscreen~trAu-42
TopSilkscreen~trAu-43
TopSilkscreen~trAu-44
TopSilkscreen~trAu-45
TopSilkscreen~trAu-46
TopSilkscreen~trAu-47
TopSilkscreen~trAu-48
TopSilkscreen~trAu-49
TopSilkscreen~trAu-50
TopSilkscreen~trAu-51
TopSilkscreen~trAu-52
TopSilkscreen~trAu-53
TopSilkscreen~trAu-54
TopSilkscreen~trAu-55
TopSilkscreen~trAu-56
TopSilkscreen~trAu-57
TopSilkscreen~trAu-58
TopSilkscreen~trAu-59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
