dudasdavid/co2-monitor-gen2/(list of files, cad)

Other CAD files:
mechanical/ESP32S3_I80_GC9A01/IPEX1.SLDASM
mechanical/ESP32S3_SPI_GC9A01/0402_CAP.SLDASM
mechanical/ESP32S3_SPI_GC9A01/0402_RES.SLDASM
mechanical/ESP32S3_I80_GC9A01/QMI8658A.SLDASM
mechanical/ESP32S3_SPI_GC9A01/TF-123B-8+9.SLDASM
mechanical/Sensor PCBA/R1~R0805~R0805_L2.0-W1.3-H0.6~trAu.SLDASM
mechanical/ESP32S3_I80_GC9A01/OSC_SMD3215.SLDASM
mechanical/ESP32S3_I80_GC9A01/0603_CAP.SLDASM
mechanical/Sensor PCBA/R4~R0805~R0805_L2.0-W1.3-H0.6~trAu.SLDASM
mechanical/ESP32S3_I80_GC9A01/RF_CA-C03.SLDASM
mechanical/ESP32S3_SPI_GC9A01/SOT323-6.SLDASM
mechanical/ESP32S3_SPI_GC9A01/0806_L.SLDASM
mechanical/ESP32S3_I80_GC9A01/SmileSwitch3x5_SidePress-1.SLDASM
mechanical/ESP32S3_I80_GC9A01/0402_CAP.SLDASM
mechanical/ESP32S3_I80_GC9A01/Diode_SOD-882.SLDASM
mechanical/ESP32S3_SPI_GC9A01/ESP32-S3.SLDASM
mechanical/ESP32S3_I80_GC9A01/FPC 0.5mm 12P_1.0H_DOWN.SLDASM
mechanical/ESP32S3_SPI_GC9A01/OSC_SMD3225.SLDASM
mechanical/ESP32S3_I80_GC9A01/ESP32S3_I80_GC9A01_Touch-Splint2-ESP32S3_I80_GC9A01_Touch-Splint.SLDASM
mechanical/ESP32S3_I80_GC9A01/FPC 0.3mm 25P_1.0H_UP.SLDASM
mechanical/ESP32S3_SPI_GC9A01/Diode_SOD-882.SLDASM
mechanical/Sensor PCBA/R6~R0805~R0805_L2.0-W1.3-H0.6~trAu.SLDASM
mechanical/ESP32S3_I80_GC9A01/SOT323-6.SLDASM
mechanical/ESP32S3_SPI_GC9A01/TYPE-C_16P-AU.SLDASM
mechanical/ESP32S3_SPI_GC9A01/SOT23-6.SLDASM
mechanical/ESP32S3_I80_GC9A01/TYPE-C_16P.SLDASM
mechanical/ESP32S3_SPI_GC9A01/0402_LED_R.SLDASM
mechanical/ESP32S3_I80_GC9A01/0402_RES.SLDASM
mechanical/ESP32S3_SPI_GC9A01/RF_CA-C03.SLDASM
mechanical/ESP32S3_SPI_GC9A01/FPC 0.5mm 12P_1.0H_DOWN.SLDASM
mechanical/ESP32S3_I80_GC9A01/TCA6408_QFN16_3x3.SLDASM
mechanical/ESP32S3_SPI_GC9A01/GC9A01_1.28_SPI.SLDASM
mechanical/ESP32S3_I80_GC9A01/TactSwitch2x3x0.6.SLDASM
mechanical/ESP32S3_SPI_GC9A01/PRTR5V0U2X,215.SLDASM
mechanical/ESP32S3_SPI_GC9A01/SmileSwitch3x5_SidePress-1.SLDASM
mechanical/ESP32S3_SPI_GC9A01/SMTSO-M2_ÃÂ†4_x+ÃÂ†1.8_x.SLDASM
mechanical/ESP32S3_I80_GC9A01/WS2812B-2020.SLDASM
mechanical/ESP32S3_SPI_GC9A01/0603_CAP.SLDASM
mechanical/ESP32S3_I80_GC9A01/WS2812B-3210.SLDASM
mechanical/ESP32S3_SPI_GC9A01/W25QXX-WSON8(5x6).SLDASM
mechanical/ESP32S3_I80_GC9A01/1_28inch-touch-lcd-sku24155.SLDASM
mechanical/ESP32S3_I80_GC9A01/TF-123B-8+9.SLDASM
mechanical/ESP32S3_SPI_GC9A01/ESP32S3_I80_GC9A01_Touch-Splint2-ESP32S3_I80_GC9A01_Touch-Splint.SLDASM
mechanical/ESP32S3_SPI_GC9A01/TactSwitch2x3x0.6.SLDASM
mechanical/ESP32S3_I80_GC9A01/SOT23-6.SLDASM
mechanical/ESP32S3_SPI_GC9A01/IPEX1.SLDASM
mechanical/ESP32S3_I80_GC9A01/ESP32-S3.SLDASM
mechanical/Sensor PCBA/R5~R0805~R0805_L2.0-W1.3-H0.6~trAu.SLDASM
mechanical/Sensor PCBA/BottomSilkscreen~trAu.SLDASM
mechanical/ESP32S3_I80_GC9A01/0402_LED_R.SLDASM
mechanical/ESP32S3_I80_GC9A01/ICS-43434.SLDASM
mechanical/ESP32S3_I80_GC9A01/W25QXX-WSON8(5x6).SLDASM
mechanical/ESP32S3_I80_GC9A01/PRTR5V0U2X,215.SLDASM
mechanical/ESP32S3_I80_GC9A01/0806_L.SLDASM
mechanical/Sensor PCBA/RTC-BAT~CONN-SMD_2P-P1.00_BX-SH1.0-2PLT~CONN-SMD_2P-P1.00_BX-SH1.0-2PLT~trAu.SLDASM
mechanical/ESP32S3_I80_GC9A01/OSC_SMD3225.SLDASM
mechanical/ESP32S3_I80_GC9A01/FPC 0.5mm 6P_1.0H.SLDASM
mechanical/Sensor PCBA/U2~SOIC-16_L10.3-W7.5-P1.27-LS10.3-BL~SOIC-16_L10.3-W7.5-H2.7-LS10.3-P1.27~trAu.SLDASM
mechanical/Sensor PCBA/TopSilkscreen~trAu.SLDASM
mechanical/ESP32S3_I80_GC9A01/SMTSO-M2_ÃÂ†4_x+ÃÂ†1.8_x.SLDASM
mechanical/Sensor PCBA/LED~CONN-SMD_SH1.0X3~CONN-SMD_SH1.0X3~trAu.SLDASM
mechanical/Sensor PCBA/U1~LGA-20_L10.1-W10.1-P1.25-TL~LGA-20_L10.1-W10.1-P1.25-TL~trAu.SLDASM
mechanical/Sensor PCBA/FPC~FPC-SMD_12P-P0.50_FPC-05F-12PH20~FPC-SMD_12P-P0.50_FPC-05F-12PH20~trAu.SLDASM
mechanical/Sensor PCBA/U4~TQFN-16_L3.0-W3.0-P0.50-BL-EP1.5~TQFN-16_L3.0-W3.0-P0.50-BL-EP1.5~trAu.SLDASM
mechanical/Sensor PCBA/U3~LGA-14_L3.0-W2.5-P0.50-TL~LGA-14_L2.5-W3.0-H0.9-P0.50~trAu.SLDASM
mechanical/Sensor PCBA/R7~R0603~R0603~trAu.SLDASM
mechanical/Sensor PCBA/C3~C0603~C0603_L1.6-W0.8-H0.8~trAu.SLDASM
mechanical/Sensor PCBA/R3~R0805~R0805_L2.0-W1.3-H0.6~trAu.SLDASM
mechanical/Sensor PCBA/R2~R0805~R0805_L2.0-W1.3-H0.6~trAu.SLDASM
mechanical/Sensor PCBA/C2~C0603~C0603_L1.6-W0.8-H0.8~trAu.SLDASM
mechanical/Sensor PCBA/LIGHT~CONN-SMD_4P-P1.00_ZX-SH1.0-4PLN~CONN-SMD_4P-P1.00_ZX-SH1.0-4PLN~trAu.SLDASM
mechanical/Sensor PCBA/R8~R0603~R0603~trAu.SLDASM
mechanical/Sensor PCBA/C1~C0603~C0603_L1.6-W0.8-H0.8~trAu.SLDASM
mechanical/ESP32S3_I80_GC9A01/COMPOUND_9.SLDPRT
mechanical/ESP32S3_SPI_GC9A01/COMPOUND_11.SLDPRT
mechanical/Sensor PCBA/TopSilkscreen~trAu-36.SLDPRT
mechanical/ESP32S3_SPI_GC9A01/COMPOUND_13.SLDPRT
mechanical/Sensor PCBA/CONN-SMD_2P-P1.00_BX-SH1.0-2PLT~CONN-SMD_2P-P1.00_BX-SH1.0-2PLT~trAu.SLDPRT
mechanical/ESP32S3_I80_GC9A01/COMPOUND_15.SLDPRT
mechanical/Sensor PCBA/TopSilkscreen~trAu-39.SLDPRT
mechanical/ESP32S3_I80_GC9A01/SOLID_9.SLDPRT
mechanical/Sensor PCBA/TopSilkscreen~trAu-44.SLDPRT
mechanical/ESP32S3_SPI_GC9A01/SOLID.SLDPRT
mechanical/Sensor PCBA/TopSilkscreen~trAu-20.SLDPRT
mechanical/ESP32S3_SPI_GC9A01/COMPOUND_8.SLDPRT
mechanical/ESP32S3_I80_GC9A01/COMPOUND_18.SLDPRT
mechanical/ESP32S3_SPI_GC9A01/COMPOUND_6.SLDPRT
mechanical/Sensor PCBA/BottomSilkscreen~trAu-117.SLDPRT
mechanical/ESP32S3_SPI_GC9A01/COMPOUND_20_GC9A01.SLDPRT
mechanical/Sensor PCBA/TopSilkscreen~trAu-66.SLDPRT
mechanical/ESP32S3_I80_GC9A01/COMPOUND_13.SLDPRT
mechanical/ESP32S3_SPI_GC9A01/SOLID_4.SLDPRT
mechanical/Sensor PCBA/TopSilkscreen~trAu-35.SLDPRT
mechanical/ESP32S3_I80_GC9A01/COMPOUND_4.SLDPRT
mechanical/ESP32S3_SPI_GC9A01/COMPOUND.SLDPRT
mechanical/Sensor PCBA/BottomSilkscreen~trAu-126.SLDPRT
mechanical/ESP32S3_SPI_GC9A01/COMPOUND_16.SLDPRT
mechanical/Sensor PCBA/BottomSilkscreen~trAu-120.SLDPRT
mechanical/ESP32S3_I80_GC9A01/COMPOUND.SLDPRT
mechanical/Sensor PCBA/TopSilkscreen~trAu-31.SLDPRT
mechanical/ESP32S3_I80_GC9A01/COMPOUND_28.SLDPRT
mechanical/Sensor PCBA/TQFN-16_L3.0-W3.0-P0.50-BL-EP1.5~TQFN-16_L3.0-W3.0-P0.50-BL-EP1.5~trAu.SLDPRT
mechanical/ESP32S3_SPI_GC9A01/COMPOUND_19.SLDPRT
mechanical/Sensor PCBA/TopSilkscreen~trAu-4.SLDPRT
mechanical/ESP32S3_SPI_GC9A01/COMPOUND_18.SLDPRT
mechanical/Sensor PCBA/BottomSilkscreen~trAu-114.SLDPRT
mechanical/ESP32S3_SPI_GC9A01/COMPOUND_2.SLDPRT
mechanical/Sensor PCBA/BottomSilkscreen~trAu-93.SLDPRT
mechanical/ESP32S3_I80_GC9A01/SOLID_7.SLDPRT
mechanical/Sensor PCBA/TopSilkscreen~trAu-64.SLDPRT
mechanical/Sensor PCBA/TopSilkscreen~trAu-79.SLDPRT
mechanical/ESP32S3_SPI_GC9A01/ESP32S3_SPI_GC9A01 PCB.SLDPRT
mechanical/Sensor PCBA/BottomSilkscreen~trAu-111.SLDPRT
mechanical/Sensor PCBA/TopSilkscreen~trAu-33.SLDPRT
mechanical/ESP32S3_I80_GC9A01/COMPOUND_8.SLDPRT
mechanical/ESP32S3_SPI_GC9A01/COMPOUND_14.SLDPRT
mechanical/Sensor PCBA/TopSilkscreen~trAu-69.SLDPRT
mechanical/ESP32S3_I80_GC9A01/COMPOUND_5.SLDPRT
mechanical/ESP32S3_SPI_GC9A01/COMPOUND_3.SLDPRT
mechanical/Sensor PCBA/BottomSilkscreen~trAu-106.SLDPRT
mechanical/ESP32S3_I80_GC9A01/SOLID_5.SLDPRT
mechanical/ESP32S3_SPI_GC9A01/COMPOUND_9.SLDPRT
mechanical/ESP32S3_I80_GC9A01/SOLID_10.SLDPRT
mechanical/ESP32S3_SPI_GC9A01/COMPOUND_20.SLDPRT
mechanical/Sensor PCBA/BottomSilkscreen~trAu-100.SLDPRT
mechanical/ESP32S3_I80_GC9A01/SOLID_6.SLDPRT
mechanical/Sensor PCBA/TopSilkscreen~trAu-27.SLDPRT
mechanical/ESP32S3_SPI_GC9A01/COMPOUND_7.SLDPRT
mechanical/Sensor PCBA/TopSilkscreen~trAu-77.SLDPRT
mechanical/ESP32S3_I80_GC9A01/COMPOUND_26.SLDPRT
mechanical/Sensor PCBA/BottomSilkscreen~trAu-104.SLDPRT
mechanical/ESP32S3_I80_GC9A01/SOLID.SLDPRT
mechanical/102535_battery.SLDPRT
mechanical/ESP32S3_I80_GC9A01/BQ25170.SLDASM
mechanical/ESP32S3_I80_GC9A01/COMPOUND_10.SLDPRT
mechanical/ESP32S3_I80_GC9A01/COMPOUND_11.SLDPRT
mechanical/ESP32S3_I80_GC9A01/COMPOUND_12.SLDPRT
mechanical/ESP32S3_I80_GC9A01/COMPOUND_14.SLDPRT
mechanical/ESP32S3_I80_GC9A01/COMPOUND_16.SLDPRT
mechanical/ESP32S3_I80_GC9A01/COMPOUND_17.SLDPRT
mechanical/ESP32S3_I80_GC9A01/COMPOUND_19.SLDPRT
mechanical/ESP32S3_I80_GC9A01/COMPOUND_2.SLDPRT
mechanical/ESP32S3_I80_GC9A01/COMPOUND_20.SLDPRT
mechanical/ESP32S3_I80_GC9A01/COMPOUND_21.SLDPRT
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
