dudasdavid/co2-monitor-gen2/documents/i80/SimpleSchematic.pdf

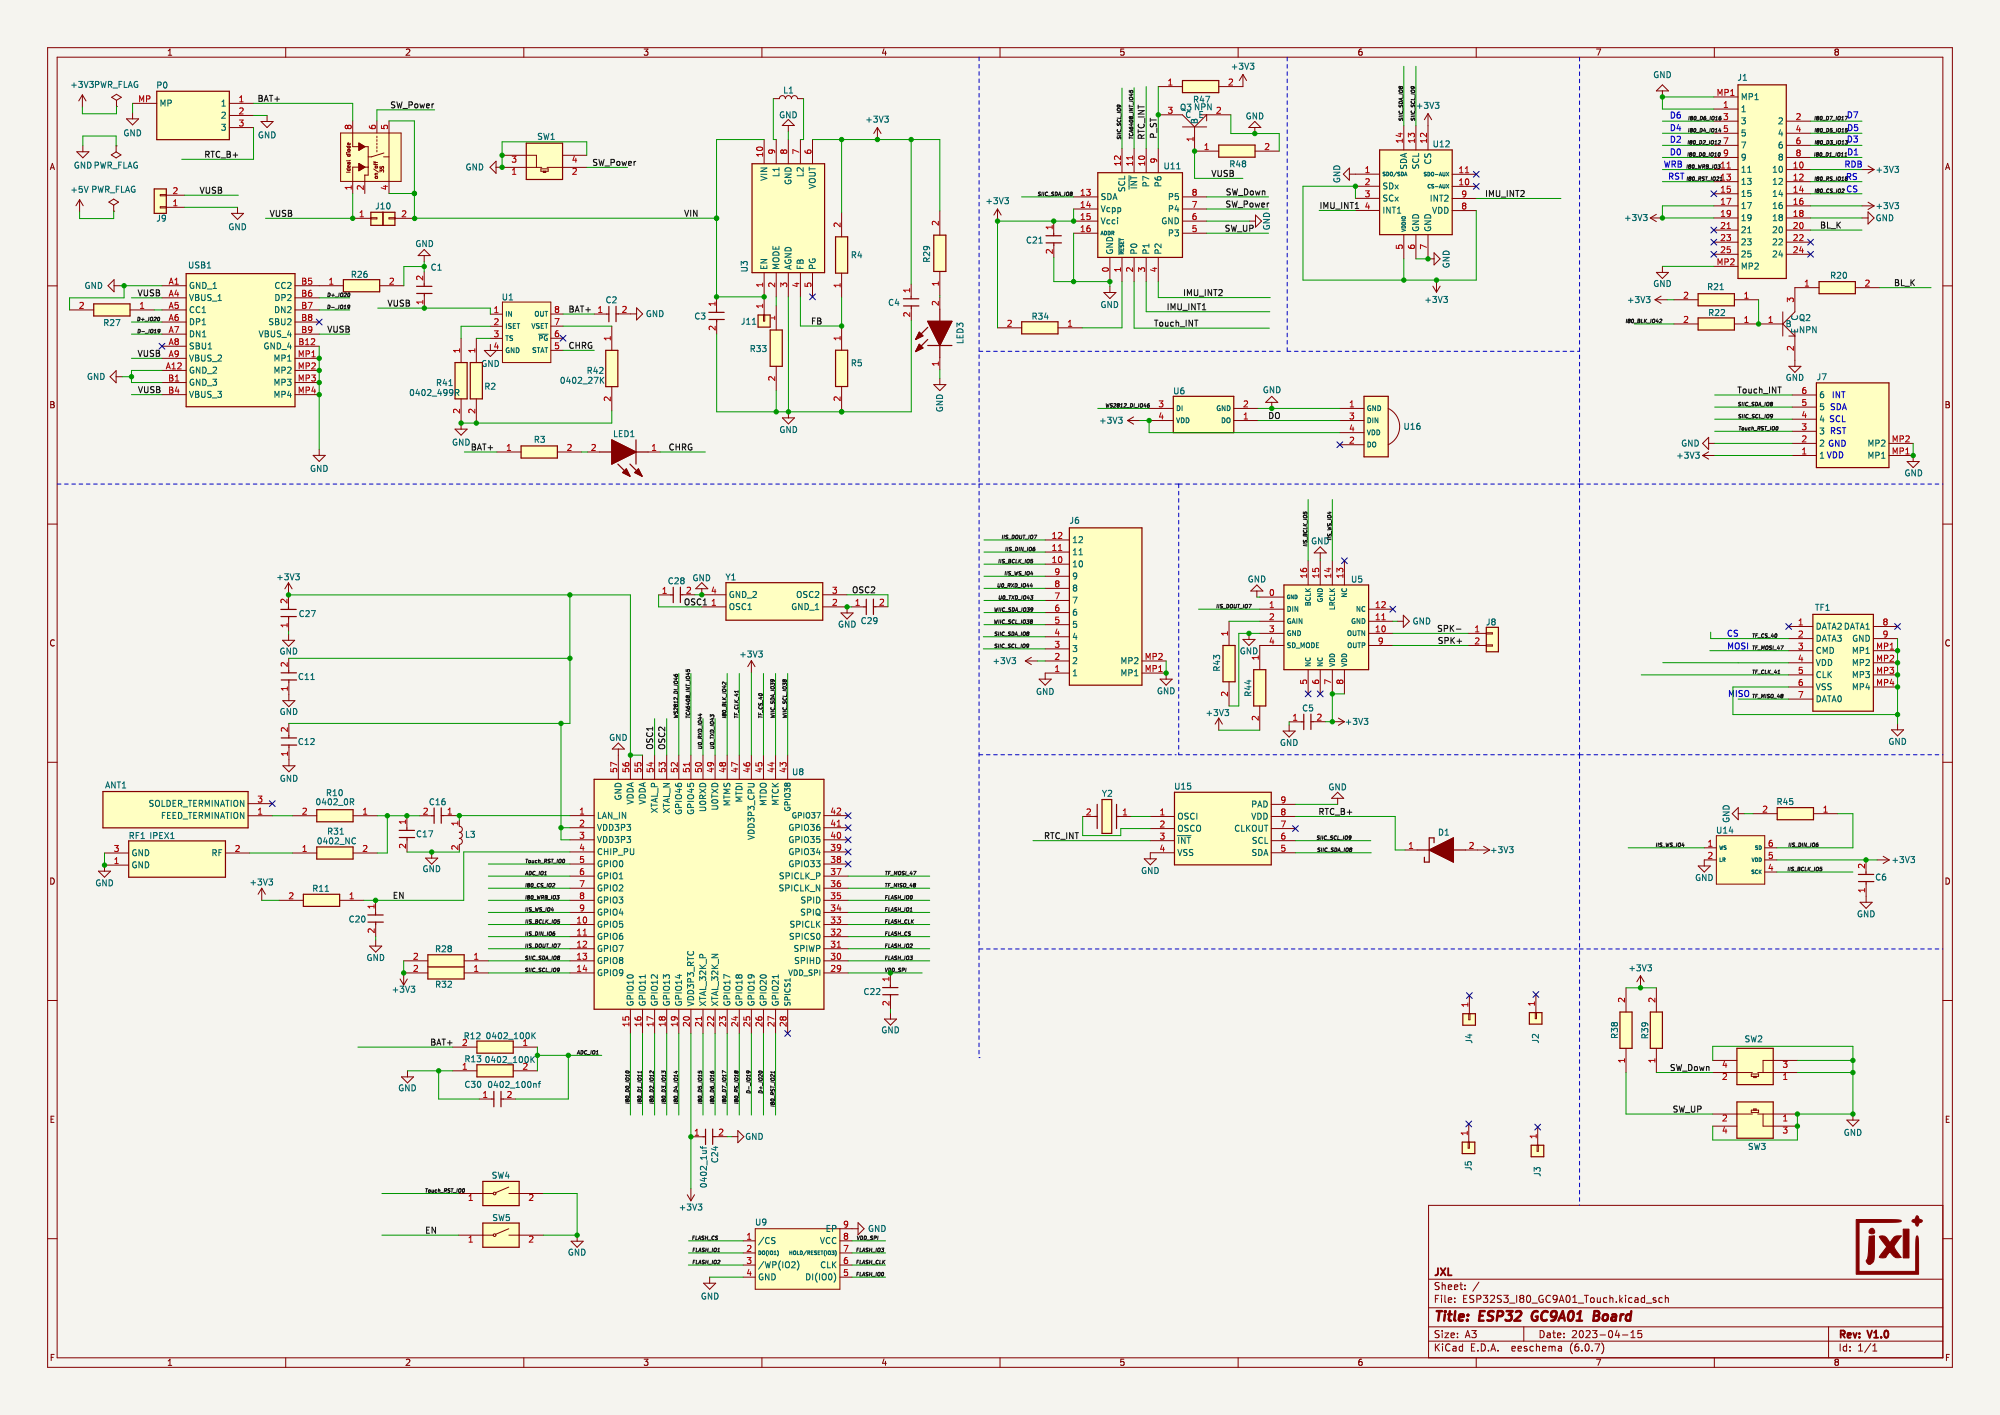
[picture p67: page 1]
