dudasdavid/co2-monitor-gen2/firmware/main_dev.py

from lv_port import init
import gc9a01
import lcd_bus
from machine import SPI, Pin, PWM
from micropython import const
import gc
import i2c  # NOQA
import task_handler  # NOQA
import cst816s

import uasyncio as asyncio
from services.idle_task import idle_task
from services.led_task import led_task
from services.backlight_task import backlight_task
from services.sensor_task import sensor_task
from services.io_expander_task import io_expander_task
from services.io_task import io_task
from services.imu_task import imu_task
from services.rtc_task import rtc_task
from services.adc_task import adc_task
from services.networking_task import networking_task
from services.history_task import history_task
from services.storage_task import storage_task
from services.audio_task import audio_task
from services.event_handler_task import event_handler_task
from services.ap_auto_disable_task import ap_auto_disable_task
from services.mqtt_task import mqtt_task
from services.display_handler_task import display_handler_task
from services.asyncio_jitter_monitor import asyncio_jitter_monitor

from logger import Logger

# ---- Global variables ----
import shared_variables as var

i2c_bus = None
lv_task_handler = None
# Default parameters
_WIDTH = const(240)
_HEIGHT = const(240)
# i80 display pins
_LCD_CS = const(2)
_LCD_WRB = const(3)
_LCD_D0 = const(10)
_LCD_D1 = const(11)
_LCD_D2 = const(12)
_LCD_D3 = const(13)
_LCD_D4 = const(14)
_LCD_D5 = const(15)
_LCD_D6 = const(16)
_LCD_D7 = const(17)
_LCD_RS = const(18)
_LCD_RST = const(21)
_LCD_BACKLIGHT = const(42)
_LCD_FREQ = const(6000000)
# SPI display pins
_LCD_SPI_FREQ = const(20000000)
_LCD_DC = const(18)
#_LCD_CS = const(2)
#_LCD_RST = const(21)
#_LCD_BACKLIGHT = const(42)
_SPI_HOST = const(1)
_SPI_SCK = const(3)
_SPI_MOSI = const(10)
_SPI_MISO = const(0)

_BUFFER_LINES = const(40)
_BUFFER_SIZE = const(240 * _BUFFER_LINES * 2)
#_BUFFER_SIZE = const(75000)

# touch device pins
_SCL = const(9)
_SDA = const(8)
_I2C_FREQ = const(100000)
_TP_RST = const(0)

# Display orientation table constants to fix rotations
_MADCTL_MV = const(0x20)  # 0=Normal, 1=Row/column exchange
_MADCTL_MX = const(0x40)  # 0=Left to Right, 1=Right to Left
_MADCTL_MY = const(0x80)  # 0=Top to Bottom, 1=Bottom to Top

def init_display_i80():
    # Initialize LVGL
    lv = init()

    # Initialize the display bus
    display_bus = lcd_bus.I80Bus(
        dc = _LCD_RS,
        wr = _LCD_WRB,
        freq=_LCD_FREQ,
        data0=_LCD_D0,
        data1=_LCD_D1,
        data2=_LCD_D2,
        data3=_LCD_D3,
        data4=_LCD_D4,
        data5=_LCD_D5,
        data6=_LCD_D6,
        data7=_LCD_D7
    )

    # Set a big enough buffer to have smooth experience (in expense of RAM)
    fb1 = display_bus.allocate_framebuffer(_BUFFER_SIZE, lcd_bus.MEMORY_INTERNAL | lcd_bus.MEMORY_DMA)
    fb2 = display_bus.allocate_framebuffer(_BUFFER_SIZE, lcd_bus.MEMORY_INTERNAL | lcd_bus.MEMORY_DMA)

    # Initialize the GC9A01 display driver
    display = gc9a01.GC9A01(
        data_bus = display_bus,
        frame_buffer1=fb1,
        frame_buffer2=fb2,
        display_width = _WIDTH,
        display_height = _HEIGHT,
        reset_pin = _LCD_RST,
        reset_state = gc9a01.STATE_LOW,
        power_on_state = gc9a01.STATE_HIGH,
        backlight_pin=_LCD_BACKLIGHT,
        offset_x=0,
        offset_y=0,
        color_space=lv.COLOR_FORMAT.RGB565,
        rgb565_byte_swap=True
    )
    
    # Update orientation table that matches the screen
    display._ORIENTATION_TABLE = (
        0,
        _MADCTL_MY | _MADCTL_MV,
        _MADCTL_MY | _MADCTL_MX,
        _MADCTL_MX | _MADCTL_MV
    )
        
    # Initialize display
    display.set_power(True)
    display.init()
    display.set_backlight(1) # It can be only 0 = OFF or 1 = ON, no dimming in display driver

    # Initialize I2C bus that has the touch controller (shared with IMU and IO expander)
    global i2c_bus
    i2c_bus = i2c.I2C.Bus(host=0, scl=_SCL, sda=_SDA, freq=_I2C_FREQ, use_locks=False)
    touch_dev = i2c.I2C.Device(bus=i2c_bus, dev_id=cst816s.I2C_ADDR, reg_bits=cst816s.BITS)

    indev = cst816s.CST816S(touch_dev, reset_pin=_TP_RST)

    if not indev.is_calibrated:
        display.set_backlight(1)
        indev.calibrate()

    var.indev = indev

    # Start LVGL's periodic handler for redraws, input, animations, and timers.
    global lv_task_handler
    lv_task_handler = task_handler.TaskHandler()
    
    return display

def init_display_spi():
    # Initialize LVGL
    lv = init()

    # Initialize the display bus
    spi_bus = SPI.Bus(
        host = _SPI_HOST,
        mosi = _SPI_MOSI,
        miso = _SPI_MISO,
        sck = _SPI_SCK
    )

    # Initialize the display bus
    display_bus = lcd_bus.SPIBus(
        spi_bus = spi_bus,
        dc = _LCD_DC,
        cs = _LCD_CS,
        freq=_LCD_SPI_FREQ 
    )

    # Set a big enough buffer to have smooth experience (in expense of RAM)
    fb1 = display_bus.allocate_framebuffer(_BUFFER_SIZE, lcd_bus.MEMORY_INTERNAL | lcd_bus.MEMORY_DMA)
    fb2 = display_bus.allocate_framebuffer(_BUFFER_SIZE, lcd_bus.MEMORY_INTERNAL | lcd_bus.MEMORY_DMA)

    # Initialize the GC9A01 display driver
    display = gc9a01.GC9A01(
        data_bus = display_bus,
        frame_buffer1=fb1,
        frame_buffer2=fb2,
        display_width = _WIDTH,
        display_height = _HEIGHT,
        reset_pin = _LCD_RST,
        reset_state = gc9a01.STATE_LOW,
        power_on_state = gc9a01.STATE_HIGH,
        backlight_pin=_LCD_BACKLIGHT,
        offset_x=0,
        offset_y=0,
        color_space=lv.COLOR_FORMAT.RGB565,
        rgb565_byte_swap=True
    )

    # Update orientation table that matches the screen
    display._ORIENTATION_TABLE = (
        0,
        _MADCTL_MY | _MADCTL_MV,
        _MADCTL_MY | _MADCTL_MX,
        _MADCTL_MX | _MADCTL_MV
    )
    
    # Initialize display
    display.set_power(True)
    display.init()
    display.set_backlight(1) # It can be only 0 = OFF or 1 = ON, no dimming in display driver

    # Initialize I2C bus that has the touch controller (shared with IMU and IO expander)
    global i2c_bus
    i2c_bus = i2c.I2C.Bus(host=0, scl=_SCL, sda=_SDA, freq=_I2C_FREQ, use_locks=False)
    touch_dev = i2c.I2C.Device(bus=i2c_bus, dev_id=cst816s.I2C_ADDR, reg_bits=cst816s.BITS)

    indev = cst816s.CST816S(touch_dev, reset_pin=_TP_RST)

    if not indev.is_calibrated:
        display.set_backlight(1)
        indev.calibrate()

    var.indev = indev

    # Start LVGL's periodic handler for redraws, input, animations, and timers.
    global lv_task_handler
    lv_task_handler = task_handler.TaskHandler()
    
    return display

async def main():

    log = Logger("main", debug_enabled=False)
    
    # 0) start watchdog (optional)
    #wdt = machine.WDT(timeout=8000)
    
    # 1) Spawn the most important threads, starting with LED lights and sensor init
    asyncio.create_task(sensor_task(0.3))                        # Performance ✅
    asyncio.create_task(led_task(0.03))                          # Performance ✅
    await asyncio.sleep(0.2)
    
    # 2) initialize display
    if var.hw_variant in ["i80", "i80_new"]:
        display = init_display_i80()
    elif var.hw_variant == "spi":
        display = init_display_spi()
    # Else is not needed because valid hw variants are already checked in main.py
    
    lv = init()
    global i2c_bus
    
    log.info("LVGL version:", lv.version_major(), lv.version_minor(), lv.version_patch())
    gc.collect()
    log.info("Free RAM at startup:", int(gc.mem_free() / 1024), "kB")
    
    # 3) Immediately start jitter monitoring tool with 50ms, enable it only for debugging
    if var.debug:
        asyncio.create_task(asyncio_jitter_monitor(50))          # Performance ✅
    
    # 4) Import slim ui_welcome and start the welcome screen
    from ui import ui_welcome
    ui_welcome.create_welcome_screen()                           # Performance ✅
    
    # 4.1) Import the rest of UI only here, might take some time
    from ui import ui_generic
    from ui import ui_chart
    from ui import ui_games
    from ui import ui_sensors
    from ui import ui_settings
    from ui import ui_table
    
    # 5) Start loading history from log with frequent yielding
    asyncio.create_task(history_task(2))                         # Performance ✅
    asyncio.create_task(storage_task(5))                         # Performance ✅
    # 5.1) During log loading we can play the startup tune
    await asyncio.sleep(0.1)
    asyncio.create_task(audio_task())                            # Performance ✅
    if not var.debug:
        await asyncio.sleep(5)
    # 5.2) Keep spawning other services
    asyncio.create_task(idle_task(3))                            # Performance ✅
    asyncio.create_task(backlight_task(0.1))                     # Performance ✅
    asyncio.create_task(adc_task(1))                             # Performance ✅
    # 5.3) Spawn some HW dependent services
    if var.hw_variant == "i80":
        asyncio.create_task(io_expander_task(i2c_bus, 0.5))      # Performance ✅
        asyncio.create_task(imu_task(i2c_bus, 0x6b, 0.04))       # Performance ✅
        asyncio.create_task(rtc_task(i2c_bus, 10))               # Performance ✅
        pass
    elif var.hw_variant == "i80_new":
        asyncio.create_task(io_expander_task(i2c_bus, 0.5))      # Performance ✅
        asyncio.create_task(imu_task(i2c_bus, 0x6a, 0.04))       # Performance ✅
    elif var.hw_variant == "spi":
        asyncio.create_task(io_task(0.5))                        # Performance ✅
        pass

    # 5.4) Start event and display handlers after IO and IMU started
    asyncio.create_task(event_handler_task())                    # Performance ✅
    asyncio.create_task(display_handler_task(display, 0.1))      # Performance ✅

    # 5.5) Only start networking related stuff after everything else started
    asyncio.create_task(networking_task(30, 60))                 # Performance ✅
    asyncio.create_task(ap_auto_disable_task(1))                 # Performance ✅
    asyncio.create_task(mqtt_task(10))                           # Performance ✅
    
    # 6) start UI  
    ui_table.create_sensor_table(alt = True)                     # Performance ✅
    ui_sensors.create_co2_screen()                               # Performance ✅
    ui_chart.create_co2_chart_screen()                           # Performance ✅
    ui_sensors.create_sensor_screen()                            # Performance ✅
    ui_settings.create_timezone_screen(alt = True)               # Performance ✅
    ui_settings.create_ap_screen(alt = True)                     # Performance ✅
    ui_settings.create_roll_indicator_screen(alt = True)         # Performance ✅
    var.snake_screen = ui_games.create_snake_screen(game = True) # Performance TO BE CHECKED
    #ui_generic.create_dummy_screen()
    ui_generic.show_screen(0, lv.SCREEN_LOAD_ANIM.FADE_IN) # start with screen 0

    log.info("Free RAM after UI:", int(gc.mem_free() / 1024), "kB")

    while True:     
              
        await asyncio.sleep(10)
        '''
        display.set_rotation(lv.DISPLAY_ROTATION._90)
        await asyncio.sleep(10)
        display.set_rotation(lv.DISPLAY_ROTATION._180)
        await asyncio.sleep(10)
        display.set_rotation(lv.DISPLAY_ROTATION._270)
        await asyncio.sleep(10)
        display.set_rotation(lv.DISPLAY_ROTATION._0)
        '''

if __name__ == "__main__":
    try:
        asyncio.run(main())
    finally:
        asyncio.new_event_loop()
