dudasdavid/co2-monitor-gen2/firmware/services/storage_task.py

import uasyncio as asyncio
import os
from logger import Logger
import time

# ---- Global variables ----
import shared_variables as var


log = Logger("stor", debug_enabled=False)

CSV_HEADER = "timestamp,temperature,temperature2,humidity,co2,lux\n"

# ---- Helpers ----

def localtime_with_offset(offset_sec=var.TZ_OFFSET):
    # get current UTC epoch
    utc_epoch = time.time()
    
    # apply offset
    local_epoch = utc_epoch + offset_sec
    
    # convert back to tuple
    return time.localtime(local_epoch)

def _format_timestamp(t):
    """
    t: (year, month, day, hour, minute, second, weekday, subsecond)
    returns: 'YYYY-MM-DD HH:MM:SS'
    """
    y, mo, d, hh, mm, ss, _, _ = t
    return "{:04d}-{:02d}-{:02d} {:02d}:{:02d}:{:02d}".format(
        y, mo, d, hh, mm, ss
    )

def _parse_timestamp(s):
    """
    'YYYY-MM-DD HH:MM:SS' -> (year, month, day, hour, minute, second)
    time.mktime expects the following format: time.mktime((2025,11,25,20,30,57,0,0))
    last 2 are dummy (0), mktime ignores them in MicroPython.
    """
    try:
        date_str, time_str = s.split(" ")
        y, mo, d = [int(x) for x in date_str.split("-")]
        hh, mm, ss = [int(x) for x in time_str.split(":")]
        return (y, mo, d, hh, mm, ss, 0, 0)
    except:
        return None
    
def _safe(value, default=0):
    """Replace None with default so formatting doesn't crash."""
    return value if value is not None else default

def _file_exists(path):
    try:
        os.stat(path)
        return True
    except OSError:
        return False


def _is_valid_csv(path):
    try:
        with open(path, "r") as f:
            first = f.readline()
            return first == CSV_HEADER
    except OSError:
        return False


def _safe_remove(path):
    try:
        os.remove(path)
    except OSError:
        pass


def _safe_rename(src, dst):
    try:
        _safe_remove(dst)
        os.rename(src, dst)
        return True
    except OSError:
        return False


def _ensure_log_file(path):
    
    CSV_EXT = ".csv"
    TMP_EXT = ".tmp"
    BAK_EXT = ".bak"
    
    csv = path + CSV_EXT
    tmp = path + TMP_EXT
    bak = path + BAK_EXT

    # 1) Always remove temp file (never trusted)
    if _file_exists(tmp):
        _safe_remove(tmp)
        log.info("Removed temp log file:", tmp)

    csv_ok = _file_exists(csv) and _is_valid_csv(csv)

    # 2) If CSV is valid → cleanup backups and return
    if csv_ok:
        if _file_exists(bak):
            _safe_remove(bak)
            log.info("Removed backup log file:", bak)
        return

    # 3) CSV missing or invalid → try restore from backup
    if _file_exists(bak) and _is_valid_csv(bak):
        if _safe_rename(bak, csv):
            log.warning("Restored log file from backup:", csv)
            return

    # 4) Nothing usable → create fresh CSV with header
    try:
        with open(csv, "w") as f:
            f.write(CSV_HEADER)
        log.warning("Created new log file with header:", csv)
    except Exception as e:
        log.error("Failed to create log file:", csv, e)

def _make_sensor_row():
    timestamp = localtime_with_offset()
    ts_str = _format_timestamp(timestamp)

    temp = _safe(var.sensor_data.temp_scd41)
    if var.hw_variant == "i80":
        temp2 = _safe(var.sensor_data.temp_qmi8658c)
    elif var.hw_variant == "spi":
        temp2 = _safe(var.sensor_data.temp_ds3231)
    else:
        temp2 = 0
    hum = _safe(var.sensor_data.humidity_scd41)
    co2 = int(_safe(var.sensor_data.co2_scd41))
    lux = _safe(var.sensor_data.lux_veml7700)

    return "{},{:.2f},{:.2f},{:.2f},{:d},{:.2f}\n".format(
        ts_str,
        temp,
        temp2,
        hum,
        co2,
        lux,
    )


async def _append_sensor_row(path):
    """
    Append one sensor row without rewriting the whole log file.
    """
    try:
        with open(path + ".csv", "a") as f:
            f.write(_make_sensor_row())

        return True
    except Exception as e:
        log.error("Failed to append sensor row:", e)
        return False


async def _count_log_rows(path, yield_every=50):
    """
    Count data rows in the CSV, excluding the header.
    """
    try:
        f = open(path + ".csv", "r")
    except OSError:
        log.warning("No log file found while counting rows:", path + ".csv")
        return 0

    try:
        header = f.readline()
        if header != CSV_HEADER:
            log.warning("Log file has invalid header while counting rows")
            return 0

        rows = 0
        while True:
            line = f.readline()
            if not line:
                break

            if line.strip():
                rows += 1

            if rows % yield_every == 0:
                await asyncio.sleep_ms(10)

        return rows
    finally:
        f.close()


async def _replace_log_rows(path, data_lines, yield_every=20):
    csv_path = path + ".csv"
    tmp_path = path + ".tmp"
    bak_path = path + ".bak"

    try:
        line_counter = 0
        f = None
        try:
            f = open(tmp_path, "w")
            f.write(CSV_HEADER)
            for l in data_lines:
                f.write(l)

                line_counter += 1
                if line_counter % yield_every == 0:
                    await asyncio.sleep_ms(10)
        finally:
            if f is not None:
                f.close()

        log.info("Log row created, total rows:", len(data_lines))

        _safe_remove(bak_path)

        if _file_exists(csv_path):
            if not _safe_rename(csv_path, bak_path):
                log.error("Failed to backup log file:", csv_path)
                _safe_remove(tmp_path)
                return

            log.debug("Log backup done")

        if not _safe_rename(tmp_path, csv_path):
            log.error("Failed to replace log file:", csv_path)

            if _file_exists(bak_path) and _safe_rename(bak_path, csv_path):
                log.warning("Restored log file from backup:", csv_path)

            return

        log.debug("New log saved")

        _safe_remove(bak_path)

        log.debug("Backup log deleted")
        return True
        
    except Exception as e:
        log.error("Failed to replace log rows:", e)
        return False


async def _compact_log(path, keep_rows, yield_every=20):
    """
    Rewrite the log file, keeping only the newest `keep_rows` data rows.
    """
    try:
        f = open(path + ".csv", "r")
    except OSError:
        log.warning("No log file found while compacting:", path + ".csv")
        return 0

    try:
        header = f.readline()
        if header != CSV_HEADER:
            log.warning("Log file has invalid header while compacting")
            return 0

        data_lines = []
        line_counter = 0

        while True:
            line = f.readline()
            if not line:
                break

            if line.strip():
                data_lines.append(line)

            line_counter += 1
            if line_counter % yield_every == 0:
                await asyncio.sleep_ms(10)

    finally:
        f.close()

    if len(data_lines) > keep_rows:
        data_lines = data_lines[-keep_rows:]

    if await _replace_log_rows(path, data_lines, yield_every):
        log.warning("Compacted log file to", len(data_lines), "rows")
        return len(data_lines)

    return await _count_log_rows(path)

async def _load_co2_history_from_log(path, yield_every=10):
    """
    Read /sd/sensor_logs.csv and rebuild var.scd41_co2_history
    from all entries in the last 24 hours.

    Each entry is just one CO2 value, in chronological order.
    """
    try:
        f = open(path + ".csv", "r")
    except OSError:
        log.warning("No log file found to restore CO2 history from:", path + ".csv")
        return

    try:
        # Skip header
        header = f.readline()
        if not header:
            log.warning("Log file empty, history not restored")
            return

        now_tuple = localtime_with_offset()
        log.debug("RTC timestamp:", now_tuple)
        
        try:
            now_ts = time.mktime(now_tuple)
        except Exception as e:
            log.error("mktime not available / failed, cannot restore history:", e)
            return

        one_day = 24 * 60 * 60
        min_ts = now_ts - one_day

        entries = []  # list of (ts_seconds, co2_int)
        line_counter = 0

        while True:
            line = f.readline()
            if not line:
                break

            line = line.strip()
            if not line:
                continue

            parts = line.split(",")
            if len(parts) < 5:
                continue

            # Yield here during file reading to make sure other asyncio tasks can run
            line_counter += 1
            if line_counter % yield_every == 0:
                await asyncio.sleep_ms(50)

            ts_str = parts[0]      # 'YYYY-MM-DD HH:MM:SS'
            co2_str = parts[4]     # co2 column

            ts_tuple = _parse_timestamp(ts_str)
            #log.debug("Log timestamp:", ts_tuple)
            if ts_tuple is None:
                continue

            try:
                ts = time.mktime(ts_tuple)
            except:
                continue

            # Only keep last 24h
            if ts < min_ts or ts > now_ts:
                continue

            try:
                co2 = int(float(co2_str))
            except Exception:
                continue

            entries.append((ts, co2))

        if not entries:
            log.warning("No recent entries (last 24h) for CO2 history")
            return

        # Ensure chronological order
        entries.sort(key=lambda x: x[0])

        # Build simple list of co2 values
        history = [co2 for _, co2 in entries]

        # Respect max history length if defined
        max_len = getattr(var, "CO2_HISTORY_MAX", None)
        if max_len is not None and len(history) > max_len:
            history = history[-max_len:]

        var.scd41_co2_history = history
        log.info("Restored CO2 history from log, length:", len(history))
        
    finally:
        f.close()

async def storage_task(period = 1.0):
    #Init
    # Get file system stats
    try:
        stats = os.statvfs('/')

        block_size = stats[0]
        total_blocks = stats[2]
        free_blocks = stats[3]

        total_space = block_size * total_blocks
        free_space = block_size * free_blocks
        used_space = total_space - free_space

        log.info("/ total space:", total_space / 1024, "kB")
        log.info("/ used space:", used_space / 1024, "kB")
        log.info("/ free space:", free_space / 1024, "kB")
        
        var.system_data.total_space_flash = total_space / 1024
        var.system_data.used_space_flash = used_space / 1024

    except Exception as e:
        var.system_data.total_space_flash = 0
        var.system_data.used_space_flash = 0
        log.error("Failed to read / stats:", e)
        
    while not (var.ntp_time_synchronized or var.rtc_time_synchronized):
        await asyncio.sleep(0.2)
        
    log_file_path = "/log/sensor_logs"
    _ensure_log_file(log_file_path)
    await _load_co2_history_from_log(log_file_path)

    var.history_loaded = True

    # We want 7 days * 24h * 12 samples/h (5 min) = 2016 rows
    MAX_ROWS = 7 * 24 * 12   # data rows (excluding header)
    COMPACT_MARGIN = 12      # Allow 1 extra hour before rewriting the file
    row_count = await _count_log_rows(log_file_path)
    log.info("Current log rows:", row_count)

    # Accumulator for 5-minute interval
    save_interval_s = 5 * 60  # 300 seconds
    elapsed = 0.0

    #Run
    while True:
        #log.debug("Task is running")      

        elapsed += period
        if elapsed >= save_interval_s:
            elapsed = 0.0
            if await _append_sensor_row(log_file_path):
                row_count += 1
                log.info("Log row created, total rows:", row_count)

                if row_count > MAX_ROWS + COMPACT_MARGIN:
                    log.warning("Log length is longer than", MAX_ROWS + COMPACT_MARGIN, ", compacting")
                    row_count = await _compact_log(log_file_path, MAX_ROWS)

        var.system_data.storage_task_timestamp = time.time()

        await asyncio.sleep(period)
