dudasdavid/co2-monitor-gen2/firmware/drivers/scd4x.py

import time
from micropython import const


class SCD4X:
    """
    Based on https://github.com/adafruit/Adafruit_CircuitPython_SCD4X
    Copyright (c) 2021 ladyada for Adafruit Industries
    MIT License
    """

    DEFAULT_ADDRESS = 0x62
    DATA_READY = const(0xE4B8)
    STOP_PERIODIC_MEASUREMENT = const(0x3F86)
    START_PERIODIC_MEASUREMENT = const(0x21B1)
    START_LOW_POWER_PERIODIC_MEASUREMENT = const(0x21AC)
    READ_MEASUREMENT = const(0xEC05)
    SERIAL_NUMBER = const(0x3682)
    SET_PRESSURE = const(0x241D)
    GET_ALTITUDE = const(0x2322)
    SET_ALTITUDE = const(0x2427)

    def __init__(self, i2c_bus, address=DEFAULT_ADDRESS):
        self.i2c = i2c_bus
        self.address = address
        self._buffer = bytearray(18)
        self._cmd = bytearray(2)
        self._crc_buffer = bytearray(2)

        # cached readings
        self._temperature = None
        self._relative_humidity = None
        self._co2 = None

        self.stop_periodic_measurement()

    @property
    def co2(self):
        """Returns the CO2 concentration in PPM (parts per million)
        .. note::
            Between measurements, the most recent reading will be cached and returned.
        """
        if self.data_ready:
            self._read_data()
        return self._co2

    @property
    def temperature(self):
        """Returns the current temperature in degrees Celsius
        .. note::
            Between measurements, the most recent reading will be cached and returned.
        """
        if self.data_ready:
            self._read_data()
        return self._temperature

    @property
    def relative_humidity(self):
        """Returns the current relative humidity in %rH.
        .. note::
            Between measurements, the most recent reading will be cached and returned.
        """
        if self.data_ready:
            self._read_data()
        return self._relative_humidity

    def _read_data(self):
        """Reads the temp/hum/co2 from the sensor and caches it"""
        self._send_command(self.READ_MEASUREMENT, cmd_delay=0.001)
        self._read_reply(self._buffer, 9)
        self._co2 = (self._buffer[0] << 8) | self._buffer[1]
        temp = (self._buffer[3] << 8) | self._buffer[4]
        self._temperature = -45 + 175 * (temp / 2 ** 16)
        humi = (self._buffer[6] << 8) | self._buffer[7]
        self._relative_humidity = 100 * (humi / 2 ** 16)

    @property
    def data_ready(self):
        """Check the sensor to see if new data is available"""
        self._send_command(self.DATA_READY, cmd_delay=0.001)
        self._read_reply(self._buffer, 3)
        return not ((self._buffer[0] & 0x03 == 0) and (self._buffer[1] == 0))

    @property
    def serial_number(self):
        """Request a 6-tuple containing the unique serial number for this sensor"""
        self._send_command(self.SERIAL_NUMBER, cmd_delay=0.001)
        self._read_reply(self._buffer, 9)
        return (
            self._buffer[0],
            self._buffer[1],
            self._buffer[3],
            self._buffer[4],
            self._buffer[6],
            self._buffer[7],
        )

    def set_ambient_pressure(self, ambient_pressure): 
        """Set the ambient pressure in hPa at any time to adjust CO2 calculations"""
        if ambient_pressure < 0 or ambient_pressure > 65535:
            raise AttributeError("`ambient_pressure` must be from 0~65535 hPascals")
        self._set_command_value(self.SET_PRESSURE, int(ambient_pressure))

    @property
    def get_altitude(self):
        """Specifies the altitude at the measurement location in metres above sea level. Setting
        this value adjusts the CO2 measurement calculations to account for the air pressure's effect
        on readings.

        .. note::
            This value will NOT be saved and will be reset on boot unless saved with
            persist_settings().
        """
        self._send_command(self.GET_ALTITUDE, cmd_delay=0.001)
        self._read_reply(self._buffer, 3)
        return (self._buffer[0] << 8) | self._buffer[1]

    def set_altitude(self, height):
        if height > 65535:
            raise AttributeError("Height must be less than or equal to 65535 metres")
        self._set_command_value(self.SET_ALTITUDE, int(height))

    def stop_periodic_measurement(self):
        """Stop measurement mode"""
        self._send_command(self.STOP_PERIODIC_MEASUREMENT, cmd_delay=0.5)

    def start_periodic_measurement(self):
        """Put sensor into working mode, about 5s per measurement"""
        self._send_command(self.START_PERIODIC_MEASUREMENT, cmd_delay=0.01)

    def start_low_periodic_measurement(self):
        """Put sensor into low power working mode, about 30s per measurement. See
        :meth:`start_periodic_measurement() <scd4x.SCD4X.start_perodic_measurement>`
        for more details.
        """
        self._send_command(self.START_LOW_POWER_PERIODIC_MEASUREMENT, cmd_delay=0.01)

    def _send_command(self, cmd, cmd_delay=0.0):
        self._cmd[0] = (cmd >> 8) & 0xFF
        self._cmd[1] = cmd & 0xFF
        self.i2c.writeto(self.address, self._cmd)
        time.sleep(cmd_delay)

    def _set_command_value(self, cmd, value, cmd_delay=0):
        self._buffer[0] = (cmd >> 8) & 0xFF
        self._buffer[1] = cmd & 0xFF
        self._crc_buffer[0] = self._buffer[2] = (value >> 8) & 0xFF
        self._crc_buffer[1] = self._buffer[3] = value & 0xFF
        self._buffer[4] = self._crc8(self._crc_buffer)
        self.i2c.writeto(self.address, self._buffer[:5])
        time.sleep(cmd_delay)

    def _read_reply(self, buff, num):
        self.i2c.readfrom_into(self.address, buff, num)
        self._check_buffer_crc(self._buffer[0:num])

    def _check_buffer_crc(self, buf):
        for i in range(0, len(buf), 3):
            self._crc_buffer[0] = buf[i]
            self._crc_buffer[1] = buf[i + 1]
            if self._crc8(self._crc_buffer) != buf[i + 2]:
                raise RuntimeError("CRC check failed while reading data")
        return True

    @staticmethod
    def _crc8(buffer):
        crc = 0xFF
        for byte in buffer:
            crc ^= byte
            for _ in range(8):
                if crc & 0x80:
                    crc = (crc << 1) ^ 0x31
                else:
                    crc = crc << 1
        return crc & 0xFF  # return the bottom 8 bits
