dudasdavid/co2-monitor-gen2/(commit log)

2026-03-19 migrate all 3D models
    [0402_CAP.SLDASM, 0402_LED_R.SLDASM, 0402_RES.SLDASM, 0603_CAP.SLDASM, 0806_L.SLDASM, 102535_battery.SLDPRT, 1_28inch-touch-lcd-sku24155.SLDASM, BQ25170.SLDASM]
2026-03-19 add board documentation
2026-03-19 migrate current FW for i80 variant
2026-03-19 handle color breathing animation on LED bar on certain screens
2026-03-19 add on board RTC driver and asyncio task
2026-03-19 turn off some debug prints
2026-03-19 fix timestamp format in shared variables
    [shared_variables.py]
2026-03-19 fix the bug in io expander task
    [io_expander_task.py]
2026-03-19 gradient circle effect is too slow on the ESP32, update on table view with RTC time
2026-03-19 move neopixel pin to 43 from 44
    I hoped it fixes the dump data at startup but nope
    [led_task.py]
2026-03-22 add io task without the io expander (spi variant)
2026-03-22 handle variants in tasks (io, imu and rtc)
2026-03-22 add spi display init and move constants outside of init functions
2026-03-23 increase initial screen brightness and handle welcome screen (no idx) in led task
2026-03-23 add temperature reading to ds3231 driver
2026-03-23 fix localtime format of ds3231 to match the pcf85063 driver
    [ds3231.py]
2026-03-23 add temperature of ds3131 to shared vars and ui for spi variant
2026-03-23 handle ds3231 for spi variant in sensor task
2026-03-24 add sensor log template file
    [sensor_logs.csv]
2026-03-25 add click audio samples
2026-03-25 add event queues for buttons and sound
2026-03-25 add an option to put an audio sample into audio queue on swipe screens
2026-03-25 change audio task to event driven from periodic, handle new audio samples
2026-03-25 upgrade IO button handling with event queues for SPI variant
2026-03-25 add an event handler who puts audio samples into audio queue based on button events
2026-03-25 play audio only after screen switch
2026-03-25 re-sample click sounds to 22050Hz
2026-03-25 upgrade io expander button handling for i80 variant
2026-03-25 fix a typo in log csv header
    [sensor_logs.csv]
2026-03-25 adjust parameters for spi variant
2026-03-26 re-sample audio to 8kHz
2026-04-08 turn off debug prints from idle and adc tasks
2026-04-08 don't reset after wifi changes
    [networking_task.py]
2026-04-08 fix a bug that LEDs were selected wrong in case of alternative screens
    [led_task.py]
2026-04-08 fix a bug that in certain cases wifi shows sleep instead of disabled
    in case of wrong wifi credentials and if there was a previous successful connection
    [networking_task.py]
2026-04-09 add a sensor screen with co2, temp and humidity
2026-04-09 handle sensor screen with LED feedback
    any sensor reading can change feedback
2026-04-09 fix a bug with 0 lux value on MQTT
    [mqtt_task.py]
2026-04-09 improve arc size on sensor screen
2026-04-09 cleanup charging variable and set charging to false by default
2026-04-09 Add battery widget and use it on sensor screens. Closes #2
2026-04-09 turn off certain debug prints
2026-04-12 led task was accidentally duplicated
2026-04-12 flash charging icon, change timer cbs for CO2 screen
2026-04-13 introduce temperature sensor calibration
2026-05-10 start working on display rotation, firsts step is fix issue with orientation table
    [main_dev.py]
2026-05-10 improve button debouncing
2026-05-10 calculate roll and pitch in IMU task
2026-05-10 disable LED animation on roll screen
2026-05-10 add jitter monitor tool that can help debugging performance issues on different screens
    [asyncio_jitter_monitor.py, main_dev.py]
2026-05-11 further reduce storage task pressure on other asyncio tasks by increasing yield frequency
2026-05-11 bugfixes of roll and pitch calculation, also reimplement it with a faster LUT based atan2
    [imu_task.py]
2026-05-11 fix angle ranges based on new roll calculation
    [display_handler_task.py]
2026-05-11 cleanup LED task
2026-05-11 improve jitter monitor logging with .2 ms formatting
    [asyncio_jitter_monitor.py]
2026-05-11 improve LED breathing animation, closes #4
2026-05-12 cut not needed tail from wav files and optimize volume of files
2026-05-12 improve handling of short sounds playing with better tails
    [audio_task.py]
2026-05-13 io task takes over power button pressing after long press so shutdown cannot be aborted. Closes #14
2026-05-13 change timing of audio samples playback
    remove delay for shutdown tune and decrease delay for normal clicks
2026-05-13 IO expander on i80 variant will also initiate a proper shutdown sequence after long press on power. Closes #16
2026-05-13 add roll and pitch offsets, closes #10
2026-05-13 asyncio profiler automatically starts in debug mode, startup delay for welcome screen is skipped in debug mode
    [main_dev.py]
2026-05-13 complete re-factoring of LED task for better expendability in the future
2026-05-16 add local and remote broker handling to mqtt service
    [mqtt_task.py]
2026-05-16 immediately start LEDs in boot.py and log any exception to file during startup
2026-05-22 fix a typo and clean up shared variables
    [mqtt_task.py, shared_variables.py]
2026-05-22 SPI screen init was not using global i2c bus
2026-05-22 initialize sensors to None so if their init fails the loop later will not crash
    [sensor_task.py]
2026-05-25 update screens that they can work on device or with simulator
2026-05-26 improve button press effect on time zone screen
2026-05-26 apply same button press effect on access point screen
2026-05-26 update roll and pitch labels to match the style of other settings' screens titles
2026-09-22 add custom PCBA for sensors
2026-09-22 update assembly parts
2026-09-22 add a printing base for solder paste printing of the sensor PCB
2026-09-22 update of main assembly models
2026-09-27 introduce new HW variant for i80 screen with custom PCBA
2026-10-10 update to the right pin number in the test script for neopixel
2026-10-10 wireless 5V module added
2026-10-10 suppress wireless 5V module design
2026-11-09 fix IMU task for new HW revision with rotated IMU
